Yatekii/project-powerline/doc/fb_fhnwreport/preamble/title.tex

\title{%
    \vspace{60mm}
    \Huge{Fachbericht} \\
    %\huge{(Entwurf)}
    \date{\today}
}
