Yatekii/project-powerline/doc/fb_fhnwreport/sections/firmware.tex

An  dieser  Stelle wird  genauer  erl\"autert,  welche \"Uberlegungen  in  die
Firmware  unseres  Systems  geflossen  sind. Weil  Sensor  und  Master-Ger\"at
jeweils  eine   eigene  Firmware   ben\"otigen,  ist  auch   dieser  Abschnitt
entsprechend aufgeteilt.

\anweisung   Diagramme    zur   Erkl\"arung    des   Aufbaus    der   Firmware
verwenden. Trockener    Text    \"uber    Software   ist    nicht    besonders
leserfreundlich.

\anweisung Bei der Verwendung von  Libraries sollen diese kurz beschrieben und
der Grund ihrer Wahl erl\"autert werden.

\anweisung   Unterkapitel  entsprechend   Gliederung  der   Firmware  sinnvoll
erg\"anzen.

% ---------------------------------------------------------------------------- %
\subsection{Sensorplatine}
\label{subsec:fw:sensorplatine}
% ---------------------------------------------------------------------------- %

Sinnvolle Beschreibung der Firmware des Sensors.

% ---------------------------------------------------------------------------- %
\subsection{Master-Ger\"at}
\label{subsec:fw:mastergerat}
% ---------------------------------------------------------------------------- %

Unterbau, GSM-Modul, Benutzeroberfl\"ache. Wichtigster Punkt: Datenauswertung.

% ---------------------------------------------------------------------------- %
\subsection{Kommunikation/Protokoll}
\label{subsec:fw:sensorplatine}
% ---------------------------------------------------------------------------- %

Wie im Abschnitt  zur Hardware wird in einem  separaten Abschnitt beschrieben,
welche \"Uberlegungen in die Entwicklung  des Protokolls eingeflossen sind und
wie das Ergebnis aussieht.
