Yatekii/project-powerline/doc/fb_fhnwreport/titlepage/titlepage.tex

\begin{titlepage}

    \maketitle

    %\vspace{60mm}
    \vspace{50mm}

    %\hspace{-20mm}
    \begin{tabular}{r|l}

        \textsc{\textbf{Studiengang}}
        & EIT\\
        [4mm]

        \textsc{\textbf{Modul}}
        & Projekt 4 \\
        [4mm]

        \textsc{\textbf{Team}}
        & 3 \\
        [4mm]

        \textsc{\textbf{Autoren}}
        & Marcel Heymann, Noah H\"usser, Raphael Frey, Dominik Keller,  \\
        & Marco Koch, Reto Nussbaumer, Francesco Rovelli                \\
        [4mm]

        \textsc{\textbf{Version}}
        & 0.1 \\
    \end{tabular}
    %\end{center}

\end{titlepage}
