Yatekii/project-powerline/admin/ph_org/sections/projektbudget.tex

% comment

% TODO: Materialkosten

Die  Personalkosten  basieren  auf  einem  Stundenansatz  von  148  CHF  f\"ur
den  Projektleiter und  74 CHF  f\"ur regul\"are  Projektmitarbeiter. Gem\"ass
ECTS-Credits stehen  nominal 1260 Stunden  zur Verf\"ugung ($7  Personen \cdot
30  Stunden/Credit \cdot  6 Credits$). Abbildung  \ref{fig:persCost} ist  eine
graphische Darstellung der Projektkosten, Tabelle \ref{tab:persCost} enth\"alt
die entsprechende Auflistung.

\begin{figure}[h!]
    \centering
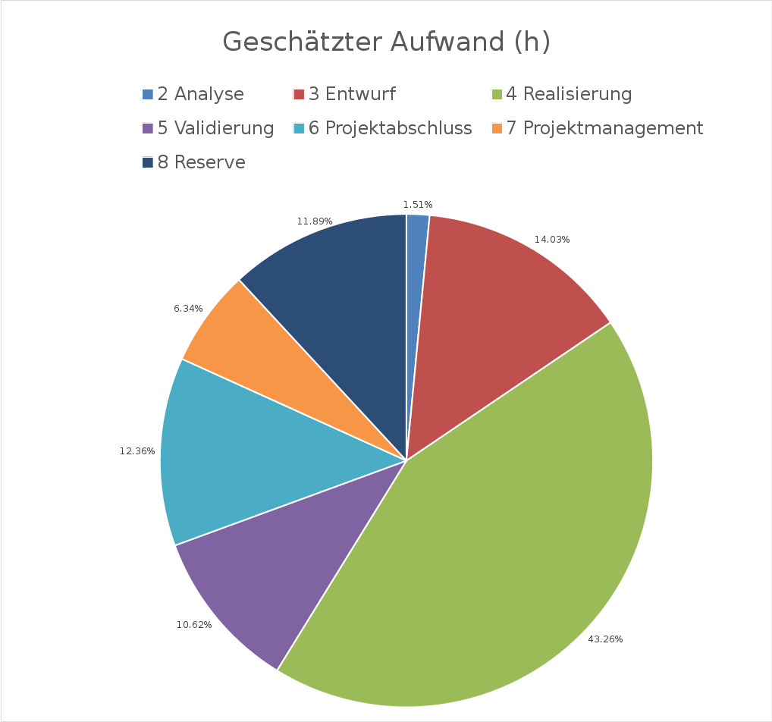
[picture p3: admin/ph_org/images/budget.png]
    
    \caption{Personalkosten}
    \label{fig:persCost}
\end{figure}

\begin{center}
    \captionof{table}{Personalkosten}
    \label{tab:persCost}
    \begin{tabular}{lp{20mm}p{20mm}p{20mm}p{20mm}}
        \toprule
                           & \multicolumn{4}{c}{gesch\"atzter Aufwand} \\
        \midrule
        Projektphase       & Anteil an Gesamtstunden (\%) & Personen-stunden (h) & Anteil an Gesamtkosten (\%) & Kosten (CHF) \\
        \midrule
        2 Analyse            &                         1.51 &                  19 &                        1.42 &        1406 \\
        3 Entwurf            &                        14.03 &                 177 &                       13.19 &       13098 \\
        4 Realisierung       &                        43.26 &                 546 &                       40.69 &       40404 \\
        5 Validierung        &                        10.62 &                 134 &                        9.99 &        9916 \\
        6 Projektabschluss   &                        12.36 &                 156 &                       11.62 &       11544 \\
        7 Projektmanagement  &                         6.34 &                  80 &                       11.92 &       11840 \\
        8 Reserve            &                        11.89 &                 150 &                       11.18 &       11100 \\
        \midrule
        \textsc{Total}       &                       100.00 &                1262 &                      100.00 &       99308 \\
        \bottomrule
    \end{tabular}
\end{center}
