Yatekii/project-powerline/admin/ph_fachl/sections/projektvereinbarung.tex

%$\square$ Projekt wird genehmigt. \\
%$\square$ Projekt wird nicht genehmigt.\\

\rule{10mm}{0.05em} Projekt wird genehmigt. \hspace{20mm} \rule{10mm}{0.05em} Projekt wird nicht genehmigt.\\

Windisch, \today \\

\begin{tabular}{p{80mm}p{80mm}}
    \parbox[t][][t]{55mm}{
        \textbf{Hans Gysin, Auftraggeber}
        \vspace*{10mm} \\
        \rule{70mm}{0.05em} \\
        Unterschrift
    } \\
    [30mm]

    \parbox[t][][t]{55mm}{
        \textbf{Reto Nussbaumer, TL}
        \vspace*{10mm} \\
        \rule{70mm}{0.05em} \\
        Unterschrift \\
    }

    &

    \parbox[t][][t]{55mm}{
        \textbf{Marco Koch}
        \vspace*{10mm} \\
        \rule{70mm}{0.05em} \\
        Unterschrift \\
    } \\
    [10mm]

    \parbox[t][][t]{55mm}{
        \textbf{Noah H\"usser}
        \vspace*{10mm} \\
        \rule{70mm}{0.05em} \\
        Unterschrift \\
    }

    &

    \parbox[t][][t]{55mm}{
        \textbf{Dominik Keller}
        \vspace*{10mm} \\
        \rule{70mm}{0.05em} \\
        Unterschrift \\
    } \\
    [10mm]

    \parbox[t][][t]{55mm}{
        \textbf{Francesco Rovelli}
        \vspace*{10mm} \\
        \rule{70mm}{0.05em} \\
        Unterschrift
    }

    &

    \parbox[t][][t]{55mm}{
        \textbf{Marcel Heymann}
        \vspace*{10mm} \\
        \rule{70mm}{0.05em} \\
        Unterschrift
    } \\
    [25mm]

    \parbox[t][][t]{55mm}{
        \textbf{Raphael Frey}
        \vspace*{10mm} \\
        \rule{70mm}{0.05em} \\
        Unterschrift
    }
\end{tabular}
