Yatekii/project-powerline/admin/ph_org/sections/appendix.tex

%\section{Zeitplan, Grossversion}
%\label{appendix:zeitplan}
%
%\clearpage
%\setlength\paperheight{297mm}
%\setlength\paperwidth{420mm}
%\setlength\pdfpageheight{\paperheight}
%\setlength\pdfpagewidth{\paperwidth}
%
%\includepdf[page=1,scale=1]{images/zeitplan.pdf}
%
%\setlength\paperheight{297mm}
%\setlength\paperwidth{210mm}
%\setlength\pdfpageheight{\paperheight}
%\setlength\pdfpagewidth{\paperwidth}

% ---------------------------------------------------------------------------- %
\section{Projektstrukturplan}
\label{app:psp}
% ---------------------------------------------------------------------------- %

\clearpage
\setlength\paperheight{297mm}
\setlength\paperwidth{420mm}
\setlength\pdfpageheight{\paperheight}
\setlength\pdfpagewidth{\paperwidth}

\includepdf[page=1-2,scale=1]{images/psp.pdf}

\setlength\paperheight{297mm}
\setlength\paperwidth{210mm}
\setlength\pdfpageheight{\paperheight}
\setlength\pdfpagewidth{\paperwidth}
