Yatekii/project-powerline/admin/ph_org/sections/kommunikationskonzept.tex

% comment

%\begin{landscape}
%\vspace*{-10mm}
Das     Kommunikationskonzept     unseres     Teams    ist     aus     Tabelle
\ref{tab:kommunikationskonzept} ersichtlich.

\begin{table}[!h]
    \small
    \caption{Kommunikationskonzept}
    \label{tab:kommunikationskonzept}
    \begin{longtable}{
        >{\raggedright}p{31mm}
        >{\raggedright}p{50mm}
        >{\raggedright}p{50mm}
        >{\raggedright}p{30mm}
        >{\raggedright}p{30mm}
        >{\raggedright\arraybackslash}p{30mm}}
    \toprule

      \textsc{Aufgabe}
    & \textsc{Zweck}
    & \textsc{Empf\"anger}
    & \textsc{Mittel}
    & \textsc{H\"aufigkeit}
    & \textsc{Verantwortl.} \\

    \midrule
    \endhead
    \midrule
    \endfoot
    \bottomrule
    \endlastfoot

    %\rowcolor[gray]{0.9}

    Kommunikation Fachdozenten
    & Fragen bei Unklarheiten
    & Fachdozenten
    & E-Mail
    & Bei Bedarf
    & PL Reto Nussbaumer \\
    [2mm]

    \rowcolor{black!10}
    Kommunikation Auftraggeber
    & Fragen bei Unklarheiten, Koordination
    & Auftraggeber
    & E-Mail
    & Bei Bedarf
    & PL Reto Nussbaumer \\
    [2mm]

    Kommunkation innerhalb Gruppe
    & Informationsaustausch, Koordination
    & Projektgruppe
    & WhatsApp, E-Mail, Slack
    & Bei Bedarf
    & Projektmitglieder \\
    [2mm]

    \rowcolor{black!10}
    Sitzungseinladung
    & Information, Koordination
    & Projektgruppe
    & WhatsApp, E-Mail
    & Bei Bedarf
    & PL Reto Nussbaumer \\
    [2mm]

    Sitzungsprotokoll
    & Pendenzen, Entscheide festhalten, orientieren
    & Projektgruppe
    & Dropbox
    & Sonntag nach jeder Sitzung
    & PL Stv. Marco Koch \\
    [2mm]

    \rowcolor{black!10}
    Pflichtenheft
    & Detaillierte Analyse der Anforderungen des Auftraggebers
    & Auftraggeber, M. Meier, P. Schleuniger, P. Buchschacher
    & E-Mail, Dropbox
    & Gem\"ass Drehbuch
    & PL Reto Nussbaumer \\
    [2mm]

    Statusbericht
    & Aktuellen Arbeitsstand festhalten
    & Auftraggeber, Fachdozenten, Projektgruppe
    & E-Mail, Dropbox
    & Gem\"ass Drehbuch
    & PL Reto Nussbaumer \\
    [2mm]

    \rowcolor{black!10}
    Zwischenpr\"asentation
    & Pr\"asentation Zwischenergebnisse
    & Auftraggeber, Fachdozenten, Projektgruppe
    & Pers\"onlich
    & Gem\"ass Drehbuch
    & Projektmitglieder \\
    [2mm]

    Schlusspr\"asentation
    & Pr\"asentation Ergebnisse
    & Auftraggeber, Fachdozenten, alle Projektgruppen
    & Pers\"onlich
    & Gem\"ass Drehbuch
    & Projektmitglieder \\

    \bottomrule
    \end{longtable}
\end{table}

%\end{landscape}
