Yatekii/project-powerline/admin/README.md

Pflichtenhefter, organisatorisch und fachlich
