Yatekii/project-powerline/admin/ph_org/preamble/title.tex

\title{%
    \vspace{60mm}
    \Huge{Pflichtenheft -- Organisatorischer Teil}
    \date{\today}
}
