Yatekii/project-powerline/doc/fb_fhnwreport/sections/fazit.tex

Was  l\"auft? Was  l\"auft  nicht? Weshalb? Weiteres Vorgehen  bei  gen\"ugend
Zeit? Schwierigkeiten w\"ahren des Projekts?
