Yatekii/project-powerline/doc/simulations/jac--m5sf-2/jac--m6sf-3--iv-curve--1.png

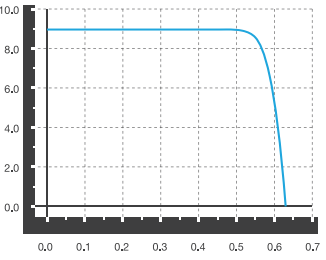
doc/simulations/jac--m5sf-2/jac--m6sf-3--iv-curve--1.png
