Yatekii/project-powerline/doc/fb_memoir/chapters/testphase.tex

% **************************************************************************** %
\chapter{Testphase}
\label{chap:testphase}
% **************************************************************************** %

Im Folgenden  wird dargelegt,  welche Tests  an unserem  System durchgef\"uhrt
worden  sind, weshalb  die  durchgef\"uhrten Tests  relevant  sind und  welche
Ergebnisse erzielt werden konnten.

\anweisung  Welche   Tests  sind   \"uberhaupt  notwendig,  um   die  korrekte
Funktionali\"at der jeweiligen Subsysteme zu verifizieren?

\anweisung Allenfalls mehr Unterkapitel hinzuf\"ugen, falls sinnvoll.

% ---------------------------------------------------------------------------- %
\section{Sensorplatine}
\label{sec:test:sensorplatine}
% ---------------------------------------------------------------------------- %

% ---------------------------------------------------------------------------- %
\section{Master-Ger\"at}
\label{sec:test:master}
% ---------------------------------------------------------------------------- %
