Yatekii/project-powerline/doc/fb_memoir/python/fsk_measurements/1_layer_power_choke_test.csv

Version=2.1.0.14
Date=06.05.2016 11:39:01
Type=foo
Inspector=
Remark=
IMax [A]=9
UMax [V]=50
TMax [µs]=100
P-Factor for L-values=0
P-Factor for LSUdt-values=0
P-Factor for SUdt-values=0
MeasCount=1
LowLimitI=
UppLimitI=
LowLimitSUdt=
UppLimitSUdt=
Serialpoints=
Divisor for L-values=1000000
Divisor for LSUdt-values=1000000
DigitsI_inc=1
DigitsSUdt_inc=0
DigitsI_sec=1
DigitsSUdt_sec=0
Ohmic resistance[Ohm]=0.2022
Serial-No.=
DPG10 L_inc(I)
0.3 | 138.9698
0.4 | 137.8259
0.5 | 137.8778
0.6 | 138.4815
0.7 | 138.1438
0.8 | 137.1349
0.9 | 136.9904
1.0 | 136.3909
1.1 | 135.7359
1.2 | 136.0925
1.3 | 136.9366
1.4 | 135.4261
1.5 | 134.4522
1.6 | 133.1436
1.7 | 132.4993
1.8 | 130.1671
1.9 | 129.5655
2.0 | 127.9529
2.1 | 125.2561
2.2 | 123.0008
2.3 | 120.0295
2.4 | 117.5924
2.5 | 114.2326
2.6 | 110.3993
2.7 | 106.051
2.8 | 101.0052
2.9 | 95.54311
3.0 | 89.97378
3.1 | 84.13519
3.2 | 77.99895
3.3 | 71.31776
3.4 | 64.86943
3.5 | 58.33348
3.6 | 52.51378
3.7 | 47.33991
3.8 | 43.01249
3.9 | 39.39716
4.0 | 36.42801
4.1 | 33.91776
4.2 | 31.78533
4.3 | 29.97807
4.4 | 28.41036
4.5 | 27.05453
4.6 | 25.85638
4.7 | 24.80999
4.8 | 23.84345
4.9 | 22.94344
5.0 | 22.14482
5.1 | 21.4234
5.2 | 20.77436
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
