Yatekii/project-powerline/doc/fb_memoir/python/fsk_measurements/1_layer_power_choke_test_zoom.csv

Version=2.1.0.14
Date=06.05.2016 11:41:37
Type=foo
Inspector=
Remark=
IMax [A]=5
UMax [V]=50
TMax [µs]=100
P-Factor for L-values=0
P-Factor for LSUdt-values=0
P-Factor for SUdt-values=0
MeasCount=1
LowLimitI=
UppLimitI=
LowLimitSUdt=
UppLimitSUdt=
Serialpoints=
Divisor for L-values=1000000
Divisor for LSUdt-values=1000000
DigitsI_inc=2
DigitsSUdt_inc=0
DigitsI_sec=2
DigitsSUdt_sec=0
Ohmic resistance[Ohm]=0.2023
Serial-No.=
DPG10 L_inc(I)
0.25 | 137.102
0.30 | 137.756
0.35 | 137.9878
0.40 | 137.4489
0.45 | 137.9692
0.50 | 138.832
0.55 | 139.6832
0.60 | 139.3316
0.65 | 138.8455
0.70 | 138.461
0.75 | 138.649
0.80 | 138.5057
0.85 | 138.8541
0.90 | 138.689
0.95 | 138.7219
1.00 | 137.8271
1.05 | 137.6815
1.10 | 137.0918
1.15 | 137.2209
1.20 | 136.6025
1.25 | 136.8542
1.30 | 137.0282
1.35 | 136.8775
1.40 | 136.3299
1.45 | 135.4548
1.50 | 135.0466
1.55 | 134.2076
1.60 | 134.497
1.65 | 134.5565
1.70 | 133.0759
1.75 | 131.7955
1.80 | 130.4676
1.85 | 130.4269
1.90 | 129.2524
1.95 | 128.4621
2.00 | 126.8568
2.05 | 125.9252
2.10 | 124.822
2.15 | 123.8328
2.20 | 122.554
2.25 | 120.2069
2.30 | 118.7336
2.35 | 116.7979
2.40 | 115.2494
2.45 | 113.6834
2.50 | 111.9591
2.55 | 110.3461
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
