Yatekii/project-powerline/admin/pma/images/ursache-wirkung.pdf

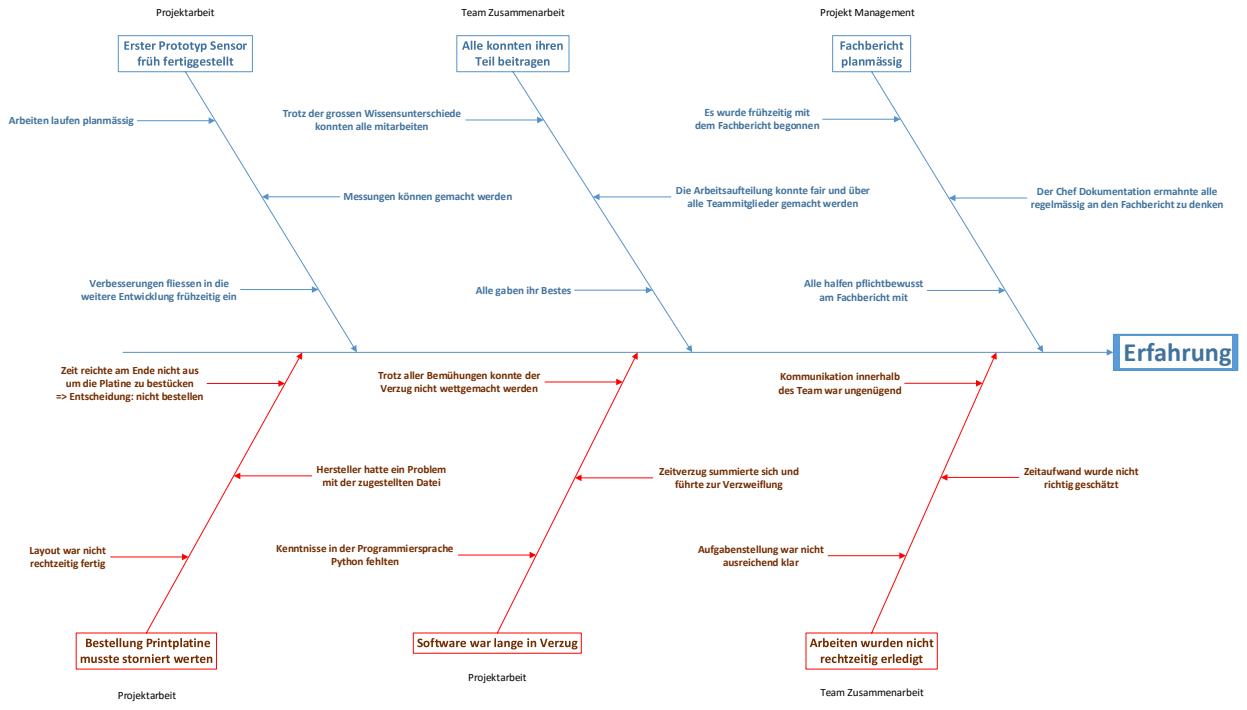
[picture p52: page 1]
Erfahrung; Python fehlten; Projektarbeit; Team Zusammenarbeit; Projekt Management

Trotz der grossen Wissensunterschiede
konnten alle mitarbeiten

Es wurde frühzeitig mit
dem Fachbericht begonnen

Arbeiten laufen planmässig

Die Arbeitsaufteilung konnte fair und über
alle Teammitglieder gemacht werden

Der Chef Dokumentation ermahnte alle
regelmässig an den Fachbericht zu denken

Messungen können gemacht werden

Verbesserungen fliessen in die
weitere Entwicklung frühzeitig ein

Alle gaben ihr Bestes

Alle halfen pflichtbewusst
am Fachbericht mit

Zeit reichte am Ende nicht aus
um die Platine zu bestücken
=> Entscheidung: nicht bestellen

Trotz aller Bemühungen konnte der
Verzug nicht wettgemacht werden

Kommunikation innerhalb
des Team war ungenügend

Hersteller hatte ein Problem
mit der zugestellten Datei

Zeitverzug summierte sich und
führte zur Verzweiflung

Zeitaufwand wurde nicht
richtig geschätzt

Layout war nicht
rechtzeitig fertig

Kenntnisse in der Programmiersprache

Aufgabenstellung war nicht
ausreichend klar
