Yatekii/project-powerline/doc/simulations/jac--m5sf-2/JAC M6SF-3 (Cypress2).pdf

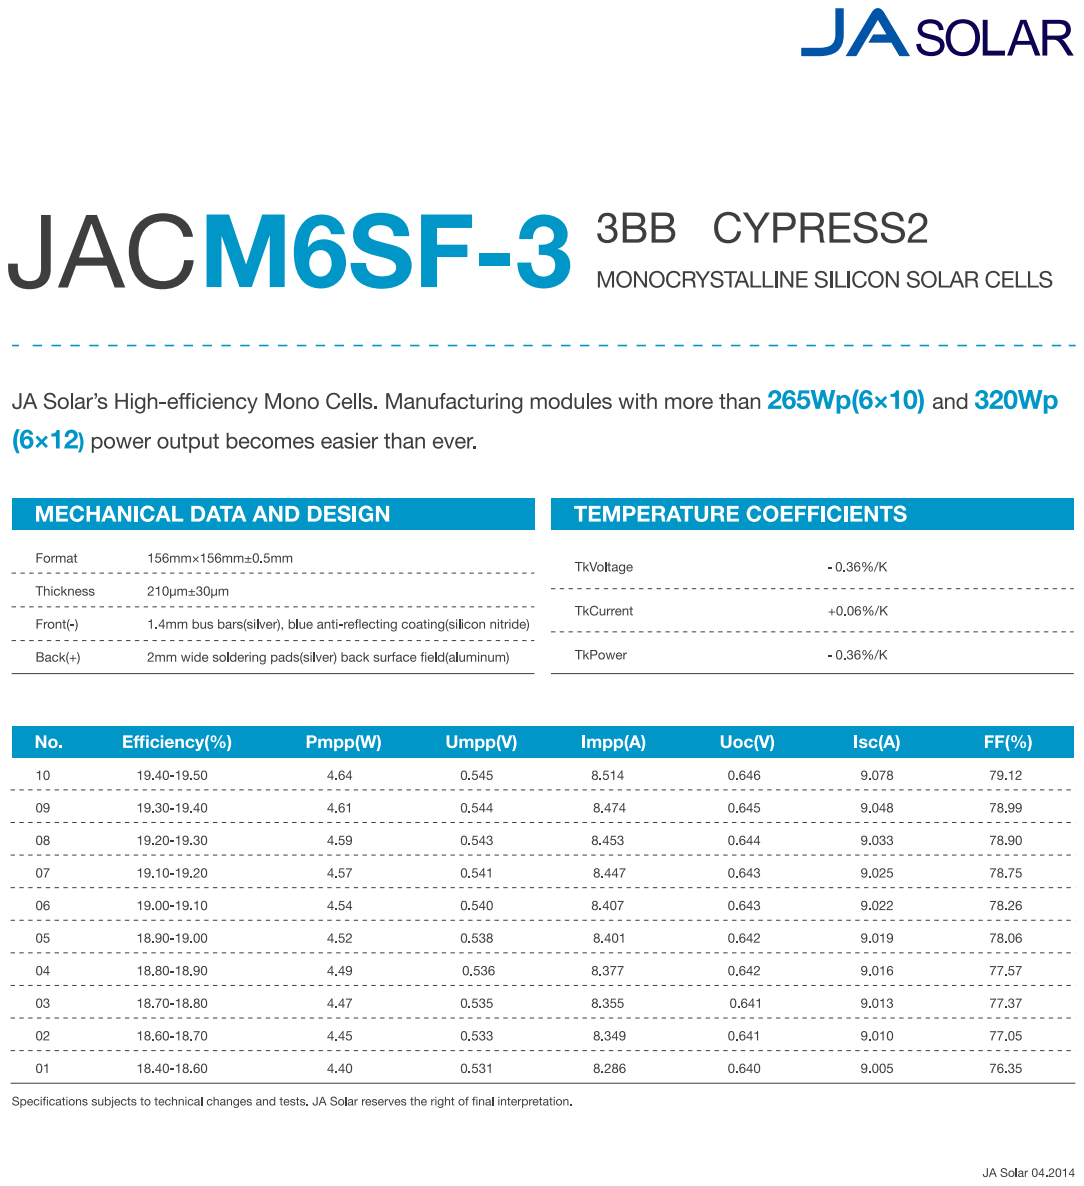
[picture p53: page 1]

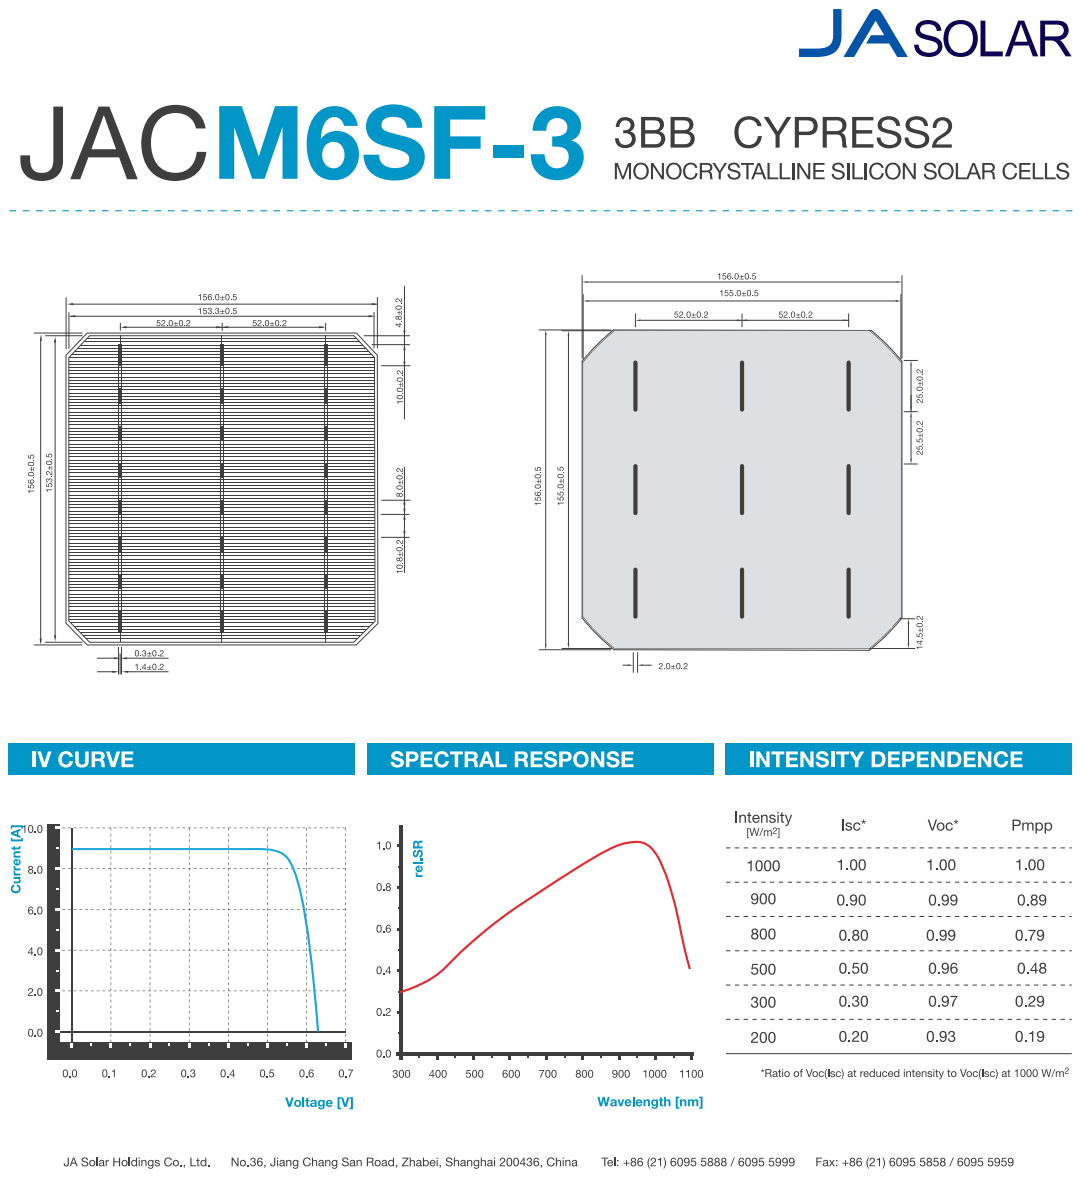
[picture p54: page 2]
