Yatekii/project-powerline/admin/ph_org/images/organigramm.pdf

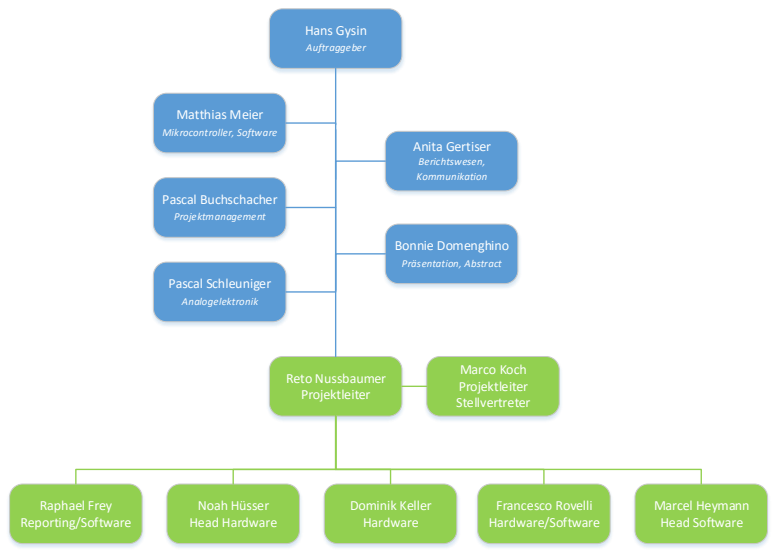
[picture p55: page 1]
Hans Gysin; Auftraggeber; Matthias Meier; Mikrocontroller, Software; Pascal Schleuniger; Analogelektronik; Pascal Buchschacher; Projektmanagement; Bonnie Domenghino; Präsentation, Abstract; Reto Nussbaumer Projektleiter; Marco Koch Projektleiter Stellvertreter; Francesco Rovelli Hardware/Software; Noah Hüsser Head Hardware; Marcel Heymann Head Software; Dominik Keller Hardware; Raphael Frey Reporting/Software; Anita Gertiser; Berichtswesen, Kommunikation
