Yatekii/project-powerline/doc/fb_memoir/images/ltspice/jac/capacitive-eps-converted-to.pdf

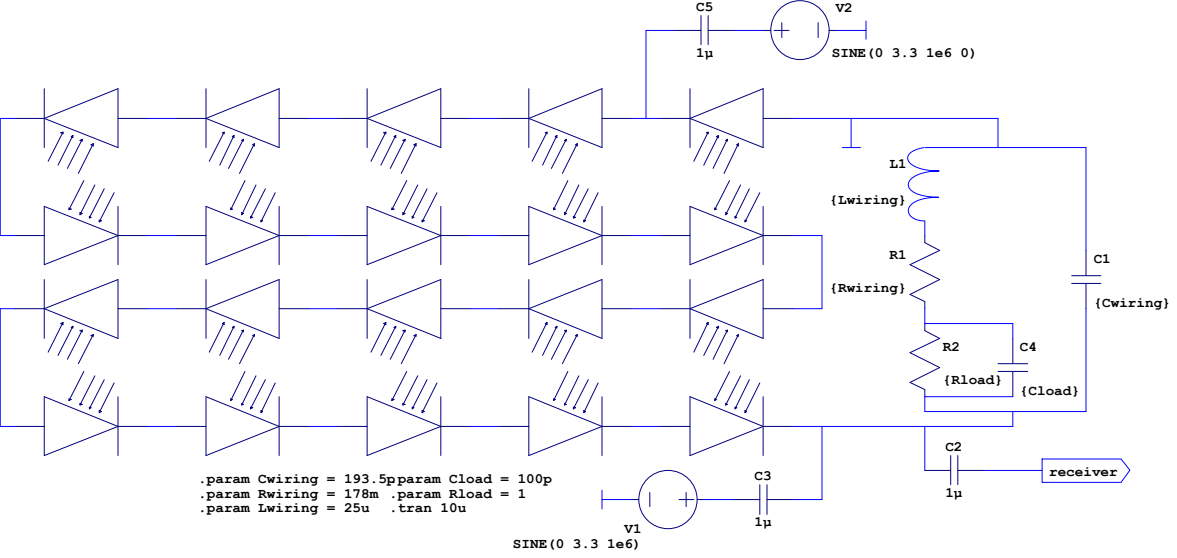
[picture p56: page 1]

.param Cwiring = 193.5p.param Cload = 100p
.param Rwiring = 178m
.param Lwiring = 25u
