Yatekii/project-powerline/hardware/supervisor/sim/Draft1.asc

C1: cap; 1µ
D1: diode; 1N914
D2: diode; 1N914
R1: res; 1
R2: res; 1000
V1: voltage; PULSE(960 900 0 10e-10 10e-10 10u 20u)
V2: voltage; 10
Named nets: 0, OUT
.tran 10m
