Yatekii/project-powerline/hardware/supervisor/sim/RX.asc

C1: cap; 100n
L1: ind; 22m
M1: nmos; BSS123
M2: pmos; BSS84
R1: res; 4k
R2: res; 1k
R3: res; 10k
R4: res; 100
R5: res; 1.5k
R6: res; 1k
R7: res; 1k
V1: voltage; PULSE(192 180 0 10e-10 10e-10 1us 2us)
V2: voltage; 3.3
Named nets: 0, IN, OUT, DIVIDER, BIASED, INVERTED
.tran 0 10ms 0 uic
