Yatekii/project-powerline/hardware/sensor/sim/sensor.asc

C2: cap; 0.8µ
C3: cap; 0.8µ
C6: cap; 0.8µ
C8: cap; 0.8µ
D1: diode; 1N914
D2: diode; 1N914
D3: diode; 1N914
D4: diode; 1N914
I1: current; 10
I3: current; 10
L1: ind; 10m
L2: ind; 10m
L4: ind; 10m
L5: ind; 10m
RL1: res; 12
RL: res; 12
V1: voltage; SINE(0 3 10k)
V2: voltage; SINE(0 1.533 10k)
Named nets: 0
.tran 100ms
