Yatekii/project-powerline/doc/simulations/jac--m5sf-2/block/test.asc

R1: res; 1
X1: jacModule; Ifail=2
Named nets: 0
.tran 1m
