Yatekii/project-powerline/doc/simulations/jac--m5sf-2/jac--m5sf-2.asc

C1: cap; {Cp}
D1: diode; diffusion
D2: diode; recombination
I1: current; {Iph}
R1: res; {Rsh}
R2: res; {Rs}
R3: res; {Rload}
Named nets: IN, OUT, 0
.model diffusion D IS=7.9406e-11 N=1
.model recombination D IS=5.0762e-6 N=2
.param Rs = 0.00171
.param Rsh = 59.23
.param Cp = 6.94u
.param Iph = 5.889
.dc dec param Rload 1e-20 1k 50 param Iph 0.05889 5.889 1.25
