Yatekii/project-powerline/doc/CD/ltspice/short/string.asc

C1: cap; 193.5p
C2: cap; {Cload}
C3: cap; 100µ
D1: zener; diodePro4
D2: zener; diodePro4
L1: ind; 25µ
M1: nmos; mos1
R1: res; 178m
R2: res; {Rload}
R3: res; 10k
R4: res; 10k
R5: res; 10k
R6: res; 1e6
V1: voltage; PULSE(0 3.3 0 0 0 {Ton} {Tperiod})
V2: voltage; 3.3
X1: jacModule
X2: jacModule
X3: jacModule
X4: jacModule
X5: jacModule
X6: jacModule
X7: jacModule
X8: jacModule
X9: jacModule
X10: jacModule
X11: jacModule
X12: jacModule
X13: jacModule
X14: jacModule
X15: jacModule
X16: jacModule
X17: jacModule
X18: jacModule
X19: jacModule
X20: jacModule
Named nets: SIGNAL, 0, RECEIVER, 3.3V
.tran 1m
.param Rload = 1000
.param Cload = 10n
.model mos1 VDMOS(Ron=20m)
.model mos1 VDMOS(Rg=3 Vto=1.7 Rd=8m Rs=6m Rb=10m Kp=70 Cgdmax=2.5n Cgdmin=.4n Cgs=2n Cjo=1n Is=80p Vds=100 Ron=20m Qg=40n)
.model diodebp D
.step dec param Cload = 1u 100u 1 dec param Rload 10 100k 1
.step dec param Rload 10 10k 1
.step dec param Cload = 1n 100u 1
.param Ton = 0.5 * Tperiod
.param Tperiod = 1e-4
.step dec param Tperiod = 1e-2 1e-5 1
.model diodePro4 D(Is=.88f Rs=.25 Cjo=175p M=.55 bv=2.7 Vj=.75 Isr=1.86n Nr=2 Ibv=20.254m Ibvl=1.96m Nbvl=15 Tbv1=-21.3u Vpk=60 type=Zener)
