Yatekii/project-powerline/doc/CD/ltspice/jac/string.asc

R1: res; {Rload}
X1: jacModule; Ifail = {Ifailure1}
X2: jacModule; Ifail = {Ifailure2}
X3: jacModule
X4: jacModule
X5: jacModule
X6: jacModule
X7: jacModule
X8: jacModule
X9: jacModule
X10: jacModule
X11: jacModule
X12: jacModule
X13: jacModule
X14: jacModule
X15: jacModule
X16: jacModule
X17: jacModule
X18: jacModule
X19: jacModule
X20: jacModule
Named nets: IN, OUT, 0
.dc dec param Rload 1e-10 1k 10 param Ifailure1 1 5.889 2 param Ifailure2 1 5.889 2
.dc dec param Rload 1e-20 100k 50 param Ifailure1 0.05889 5.889 1.25 param Ifailure2 2.94 5.889 1.47
.param Ifailure2 = 5.889
