Yatekii/project-powerline/doc/CD/ltspice/jac/stringNoD.asc

R1: res; {Rload}
X1: jacModuleNoD; Ifail = {Ifailure}
X6: jacModuleNoD
X7: jacModuleNoD
X8: jacModuleNoD
X10: jacModuleNoD
X11: jacModuleNoD
X12: jacModuleNoD
X13: jacModuleNoD
X14: jacModuleNoD
X15: jacModuleNoD
X16: jacModuleNoD
X17: jacModuleNoD
X18: jacModuleNoD
X19: jacModuleNoD
X20: jacModuleNoD
X21: jacModuleNoD
X22: jacModuleNoD
X23: jacModuleNoD
X24: jacModuleNoD
X25: jacModuleNoD
Named nets: IN, OUT, 0
.dc dec param Rload 1e-20 100k 50 param Ifailure 0.05889 5.889 1.25
.dc dec param Rload 1e-10 1k 20 param Ifailure 0.5 5.889 2
