Yatekii/project-powerline/doc/CD/ltspice/capacitive/capacitive.asc

C1: cap; {Cwiring}
C2: cap; 1µ
C3: cap; 1µ
C4: cap; {Cload}
C5: cap; 1µ
L1: ind; {Lwiring}
R1: res; {Rwiring}
R2: res; {Rload}
V1: voltage; SINE(0 3.3 1e6)
V2: voltage; SINE(0 3.3 1e6 0)
X1: jacModule
X2: jacModule
X3: jacModule
X4: jacModule
X5: jacModule
X6: jacModule
X7: jacModule
X8: jacModule
X9: jacModule
X10: jacModule
X11: jacModule
X12: jacModule
X13: jacModule
X14: jacModule
X15: jacModule
X16: jacModule
X17: jacModule
X18: jacModule
X19: jacModule
X20: jacModule
Named nets: receiver, 0
.tran 10u
.param Rload = 10
.param Cload = 10u
.param Cwiring = 193.5p
.param Rwiring = 178m
.param Lwiring = 25u
.step dec param Rload 1 1k 1 dec param Cload 1n 100u 1
