Yatekii/project-powerline/doc/CD/ltspice/inductive/singleModule.asc

L1: ind2; 500n
L2: ind2; 500n
L3: ind2; 200µ
L4: ind2; 200µ
R1: res; {Rload}
R2: res; 1e6
R3: res; 1p
V1: voltage; SINE(0 3.3 1e6)
X1: jacModule
Named nets: 0, RECEIVER
.tran 10u
K1 L1 L4 0.95
K2 L2 L3 0.95
.param Rload = 10
