Yatekii/project-powerline/doc/CD/ltspice/inductive/string.asc

C1: cap; {Cwiring}
C4: cap; {Cload}
L1: ind; {Lwiring}
L2: ind2; 500n
L3: ind2; 500n
L4: ind2; 200µ
L5: ind2; 200µ
L6: ind2; 500n
L7: ind2; 200µ
R1: res; {Rwiring}
R2: res; {Rload}
R3: res; 1p
R4: res; 1k
V1: voltage; SINE(0 3.3 1e6)
V2: voltage; SINE(0 3.3 {Freq})
X1: jacModule
X2: jacModule
X3: jacModule
X4: jacModule
X5: jacModule
X6: jacModule
X7: jacModule
X8: jacModule
X9: jacModule
X10: jacModule
X11: jacModule
X12: jacModule
X13: jacModule
X14: jacModule
X15: jacModule
X16: jacModule
X17: jacModule
X18: jacModule
X19: jacModule
X20: jacModule
Named nets: receiver, 0
.tran 200u
.param Rload = 50
.param Cload = 100u
.param Cwiring = 193.5p
.param Rwiring = 178m
.param Lwiring = 25u
K1 L2 L4 0.95
K2 L3 L5 0.95
K3 L6 L7 0.95
.step dec param Rload 1 1k 1
.step dec param Cload 1n 100u 1 dec param Rload 1 50 1
.param Freq = 243902
.step dec param Freq 1e4 1e7 1
.param Tperiod = 4.1e-6
.param Ton = 0.5*Tperiod
