Yatekii/project-powerline/doc/CD/ltspice/short/receiver.asc

C1: cap; 100µ
C2: cap; 100µ
D1: zener; diodePro4
D2: zener; diodePro4
L1: ind; 100µ
R1: res; 10k
R2: res; 10k
R3: res; 10k
R4: res; 1e6
R5: res; 1k
V1: voltage; PULSE(0 -45 1 0 0 0.5e-4 1e-4)
V2: voltage; 900
V3: voltage; 3.3
Named nets: 0, RECEIVER, 3.3V
.tran 0 10 0 1m
.model diodePro4 D(bv=2.7 Is=.88f Rs=.25 Cjo=175p M=.55 Vj=.75 Isr=1.86n Nr=2 Ibv=20.254m Ibvl=1.96m Nbvl=15 Tbv1=-21.3u Vpk=60 type=Zener)
