Yatekii/project-powerline/doc/CD/ltspice/short/single.asc

M1: nmos; mos1
R1: res; {Rload}
V1: voltage; PULSE(0 3.3 0 0 0 0.5e-4 1e-4)
X1: jacModule
Named nets: MEASURE, 0
.tran 0 61u 59u
.model mos1 VDMOS(Kp = 60 Ron=20m)
.model diodebp D
.param Rload = 100
.tran 1m
