Yatekii/project-powerline/doc/simulations/jac--m5sf-2/block/shortcircuit-cells.asc

C1: cap; {Cp}
C2: cap; {Cp}
C3: cap; {Cp}
C4: cap; {Cp}
C5: cap; {Cp}
C6: cap; {Cp}
C7: cap; {Cp}
C8: cap; {Cp}
C9: cap; {Cp}
C10: cap; {Cp}
C11: cap; {Cp}
C12: cap; {Cp}
C13: cap; {Cp}
C14: cap; {Cp}
C15: cap; {Cp}
C16: cap; {Cp}
C17: cap; {Cp}
C18: cap; {Cp}
C19: cap; {Cp}
C20: cap; {Cp}
C21: cap; {Cp}
C22: cap; {Cp}
C23: cap; {Cp}
C24: cap; {Cp}
C25: cap; {Cp}
C26: cap; {Cp}
C27: cap; {Cp}
C28: cap; {Cp}
C29: cap; {Cp}
C30: cap; {Cp}
C31: cap; {Cp}
C32: cap; {Cp}
C33: cap; {Cp}
C34: cap; {Cp}
C35: cap; {Cp}
C36: cap; {Cp}
C37: cap; {Cp}
C38: cap; {Cp}
C39: cap; {Cp}
C40: cap; {Cp}
C41: cap; {Cp}
C42: cap; {Cp}
C43: cap; {Cp}
C44: cap; {Cp}
C45: cap; {Cp}
C46: cap; {Cp}
C47: cap; {Cp}
C48: cap; {Cp}
C49: cap; {Cp}
C50: cap; {Cp}
C51: cap; {Cp}
C52: cap; {Cp}
C53: cap; {Cp}
C54: cap; {Cp}
C55: cap; {Cp}
C56: cap; {Cp}
C57: cap; {Cp}
C58: cap; {Cp}
C59: cap; {Cp}
C60: cap; {Cp}
C61: cap; {Cp}
C62: cap; {Cp}
C63: cap; {Cp}
C64: cap; {Cp}
C65: cap; {Cp}
C66: cap; {Cp}
C67: cap; {Cp}
C68: cap; {Cp}
C69: cap; {Cp}
C70: cap; {Cp}
C71: cap; {Cp}
C72: cap; {Cp}
C73: cap; {Cp}
C74: cap; {Cp}
C75: cap; {Cp}
C76: cap; {Cp}
C77: cap; {Cp}
C78: cap; {Cp}
C79: cap; {Cp}
C80: cap; {Cp}
C81: cap; {Cp}
C82: cap; {Cp}
C83: cap; {Cp}
C84: cap; {Cp}
C85: cap; {Cp}
C86: cap; {Cp}
C87: cap; {Cp}
C88: cap; {Cp}
C89: cap; {Cp}
C90: cap; {Cp}
C91: cap; {Cp}
C92: cap; {Cp}
C93: cap; {Cp}
C94: cap; {Cp}
C95: cap; {Cp}
C96: cap; {Cp}
C97: cap; {Cp}
C98: cap; {Cp}
C99: cap; {Cp}
C100: cap; {Cp}
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
.model diffusion D IS=7.9406e-11 N=1
.model recombination D IS=5.0762e-6 N=2
.param Rs = 0.00171
.param Rsh = 59.23
.param Cp = 3.125u
.param Iph = 5.889
.param Ifail = 5.889
.model diodebp D
.param LConductor = 8.74u
.param RConductor = 44.21m
.model mos1 VDMOS(Ron=20m)
.tran 1m
