Yatekii/project-powerline/doc/simulations/jac--m5sf-2/block/inductive-verySimple.asc

L1: ind2; 144n
L2: ind2; 130µ
L3: ind2; 144n
L4: ind2; 130µ
R1: res; 1p
R2: res; 1k
R3: res; 1p
V1: voltage; SINE(0 3.3 1e6)
Named nets: 0, RECEIVER
K1 L1 L2 0.8
K2 L3 L4 0.8
.tran 10u
