Yatekii/project-powerline/doc/CD/ltspice/generic/cell-9A.asc

C1: cap; {Cp}
D1: diode; diffusion
D2: diode; recombination
I1: current; {Iph}
R1: res; {Rsh}
R2: res; {Rs}
Named nets: IN, OUT
.model diffusion D IS=7.9406e-11 N=1
.model recombination D IS=5.0762e-6 N=2
.param Rs = 0.00171
.param Rsh = 20
.param Cp = 6.94u
.param Iph = 9
.dc dec param Rload 1e-20 1k 50
