Yatekii/project-powerline/hardware/sensor/sensor.kicad_pcb

## KiCad design hardware/sensor/sensor.kicad_pcb (2016-06-16)

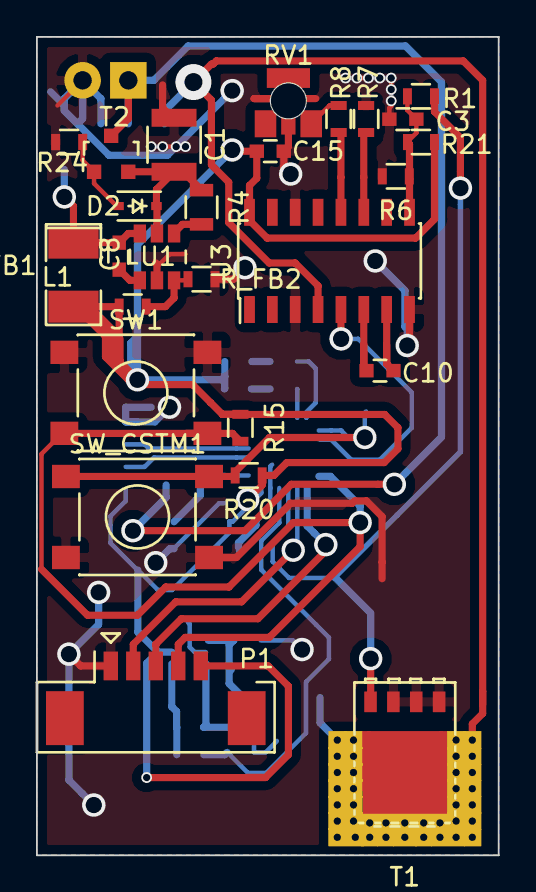
[picture p57: board sensor.kicad_pcb from above]

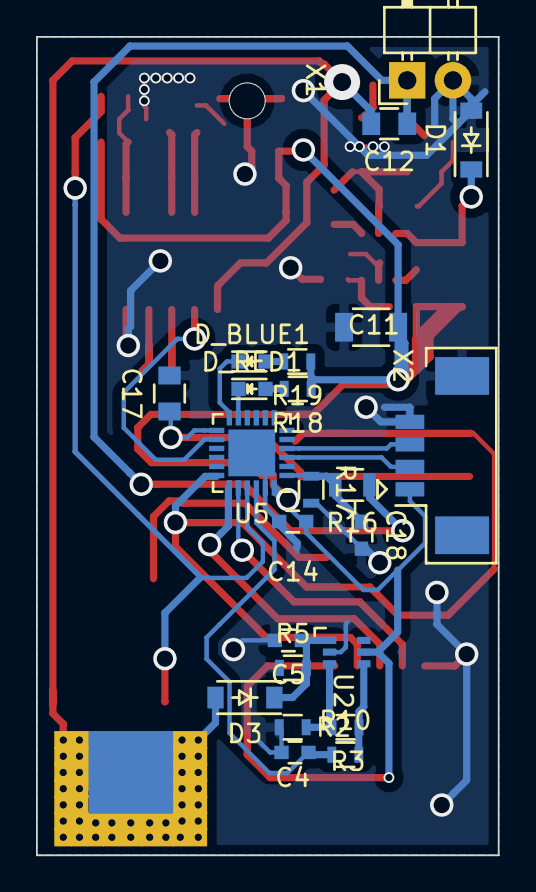
[picture p58: board sensor.kicad_pcb from below]

Board: 2 copper layers, 25.7 x 45.5 mm, 49 parts (23 on the bottom side), 33 nets.

Parts:
C1: 2.2uF; C_1210
C3, C4, C10, C18: C_Small; C_0603
C5: 0.1u; C_0603
C8: 100nF; C_0603
C11: 10uF; C_1206
C12: C_Small; C_0805
C14, C15: 100n; C_0603
C17: 1u; C_0805
D1, D3: D_Schottky_Small; SOD-123
D2: ZENER; SOD-323
D_BLUE1: BLUE; LED_0603
D_RED1: RED; LED_0603
L1: 22uH; SMD-1210_Pol
P1: CONN_01X05; Molex_PicoBlade_53261-0571
R1, R15, R20: 10k; R_0603
R2, R3, R21, R24: 100k; R_0603
R4: 1M8; R_0805
R5, R7, R8, R10: R_Small; R_0603
R6: x; R_0603
R16: 600k; R_0805
R17: 33k; R_0603
R18, R19: 100; R_0603
RV1: POT; EVM-1USX30B14_poti
R_FB1: 33k; R_0603
R_FB2: 10k; R_0603
SW1: Reset; SW_SPST_PTS645
SW_CSTM1: Cstm; SW_SPST_PTS645
T1: BUK9Y22; SOT-669_LFPAK_ThermalVias-1
T2: DMP10H4D2s; SOT-23
U1: LMR16006; TSOT-6-MK06A
U2: OPA376AIDCK; SC-70-6
U3: CD74HC4046; SOIC-16_3.9x9.9mm_Pitch1.27mm
U5: Atmel_SAM_D09; QFN-24-1EP_4x4mm_Pitch0.5mm
X1: 60V; Pin_Header_Angled_1x02
X2: UART; Molex_PicoBlade_53261-0471

Connections:
+3V3: C11.1, C14.1, C15.1, L1.2, P1.5, R15.1, R18.1, R19.1, R20.1, R21.1, R_FB1.1, U2.5, U3.16, U5.24, X2.1
/BLUE_ON: D_BLUE1.1, U5.12
/INH-Tx: U3.5, U5.14
/RED_ON: D_RED1.1, U5.11
/RX1_out: C4.1, R10.1, U5.22
/SHD: R4.2, U1.4
/SW_CSTM: C17.1, R20.2, SW_CSTM1.1, U5.13
/TX1_in: R1.2, T1.4, U5.21
/adc_0: C18.1, R16.2, R17.1, U5.1
/coupling: C12.2, D3.2, T1.5, U3.4
GND: C1.2, C3.2, C4.2, C5.2, C11.2, C14.2, C15.2, C17.2, C18.2, D1.2, P1.1, R2.2, R5.1, R6.2, R7.2, R17.2, R24.2, RV1.2, R_FB2.2, SW1.1, SW_CSTM1.2, T1.1, T1.2, T1.3, U1.2, U2.2, U3.3, U3.8, U3.14, U5.23, U5.25, X1.2, X2.4
unnamed: C1.1, D2.1, R4.1, T2.2, U1.5
unnamed: C3.1, R1.1, R6.1, R21.2, U3.9
unnamed: C5.1, D3.1, R5.2, U2.1
unnamed: C8.1, U1.1
unnamed: C8.2, D1.1, L1.1, U1.6
unnamed: C10.1, U3.6
unnamed: C10.2, U3.7
unnamed: D2.2, R24.1, T2.1
unnamed: D_BLUE1.2, R19.2
unnamed: D_RED1.2, R18.2
unnamed: P1.2, U5.20
unnamed: P1.3, U5.19
unnamed: P1.4, R15.2, SW1.2, U5.18
unnamed: R2.1, R3.2, U2.3
unnamed: R7.1, U3.11
unnamed: R8.1, U3.12
unnamed: R8.2, RV1.3
unnamed: R3.1, R10.2, U2.4
unnamed: R_FB1.2, R_FB2.1, U1.3
unnamed: U5.3, X2.2
unnamed: U5.4, X2.3
VCC: C12.1, R16.1, T2.3, X1.1
