Yatekii/project-powerline/hardware/supervisor/supervisor.kicad_pcb

## KiCad design hardware/supervisor/supervisor.kicad_pcb (2016-06-16)

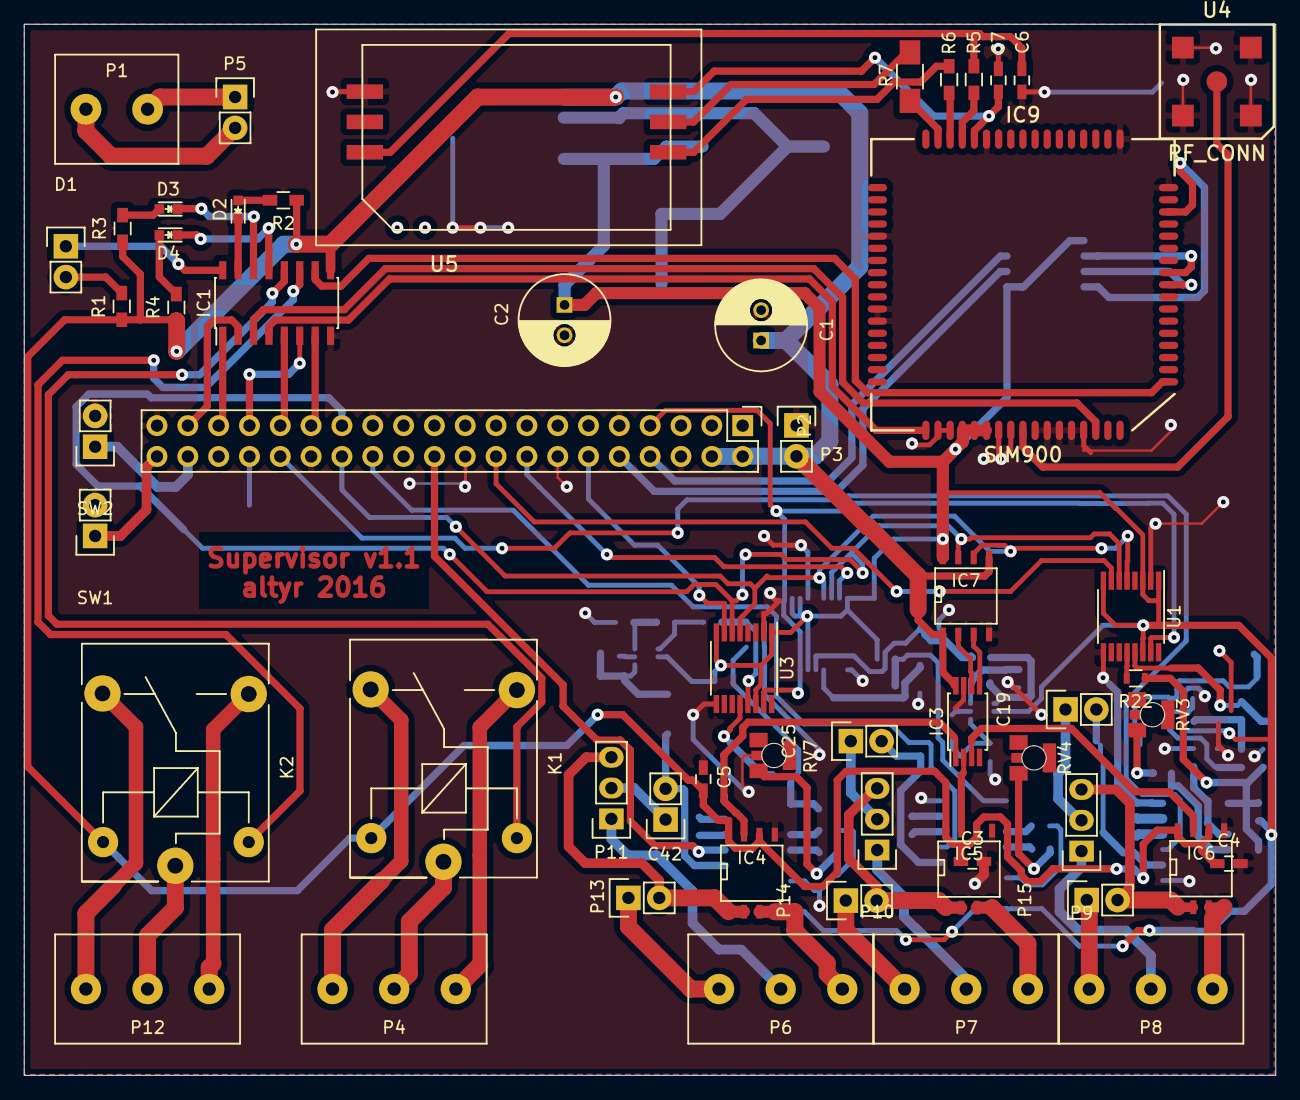
[picture p59: board supervisor.kicad_pcb from above]

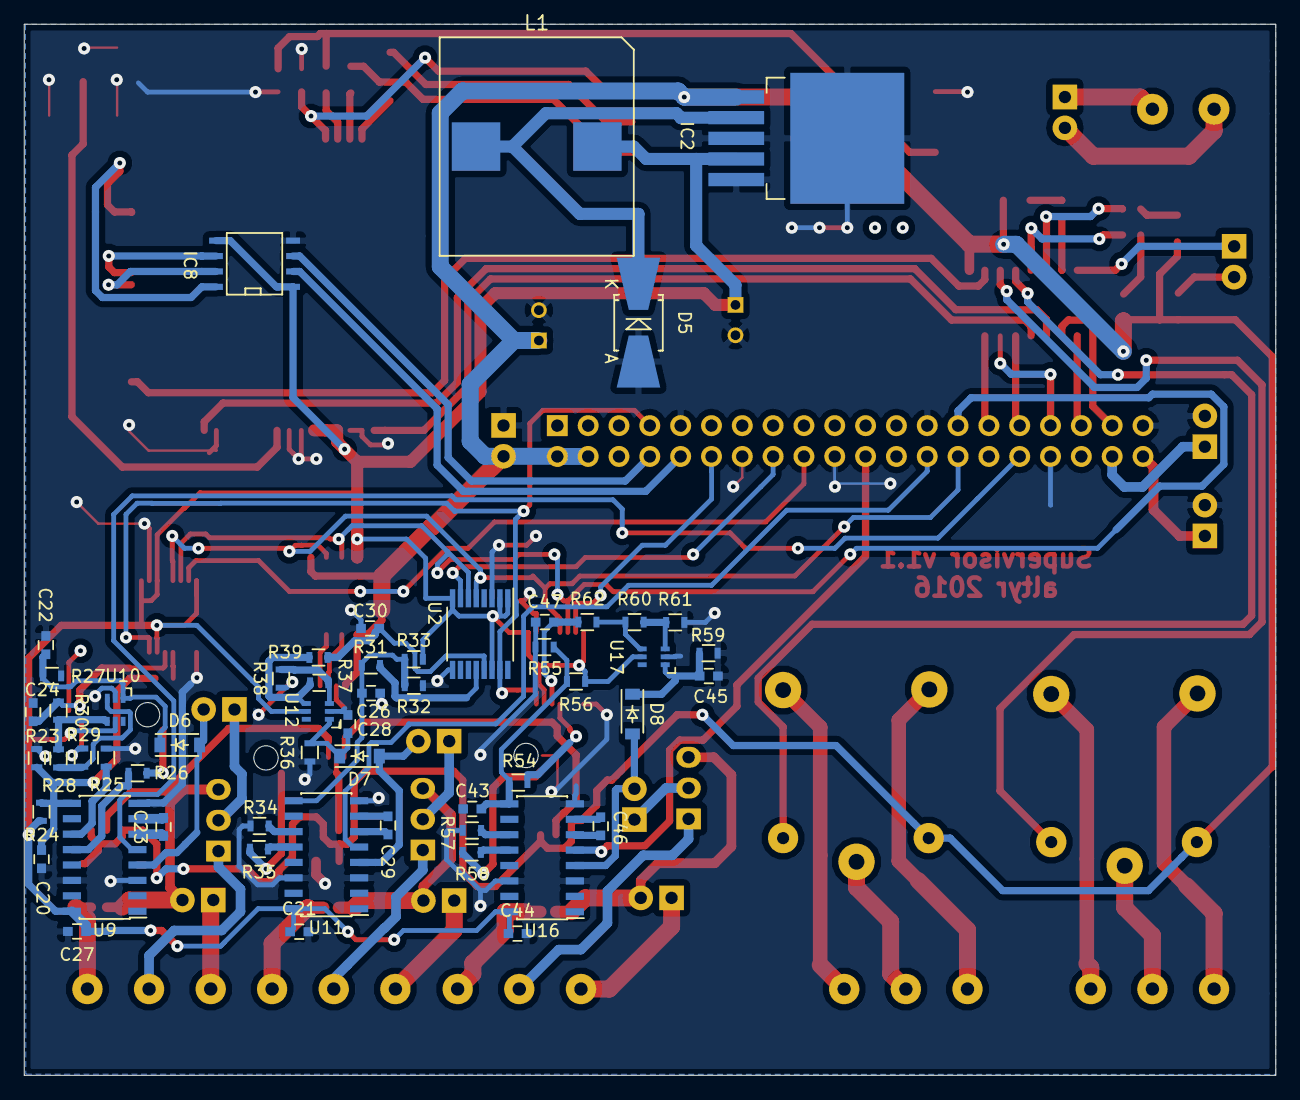
[picture p60: board supervisor.kicad_pcb from below]

Board: 2 copper layers, 103.1 x 86.6 mm, 110 parts (55 on the bottom side), 110 nets.

Parts:
C1, C2: CP_Small; C_Radial_D7.5_L11.2_P2.5
C3, C4, C5: 0.1 uF; C_0603_HandSoldering
C6: 22pF; C_0603_HandSoldering
C7: 100nF; C_0603_HandSoldering
C19, C25, C42: C_Small; Pin_Header_Straight_1x02
C20, C23, C24, C26, C29, C30, C43, C46, C47: C_Small; C_0603
C21, C27, C44: 100n; C_0603
C22, C28, C45: 0.1u; C_0603
D1: Led_Small; Pin_Header_Straight_1x02
D2, D3, D4: Led_Small; LED_0603
D5: ZENERsmall; SMB-SMC_Universal_Handsoldering
D6, D7, D8: D_Schottky_Small; SOD-123
IC1: ULN2003A; SOIC-16_3.9x9.9mm_Pitch1.27mm
IC2: LM2596-3.3; TO-263-5Lead
IC3: MAX11612; TSSOP-8_4.4x3mm_Pitch0.65mm
IC4, IC5, IC6: ACS723LLCTR-10AU-T; SOIC-8-N
IC7, IC8: NLSX4373; SOIC-8-N
IC9: SIM900; QFP 68
K1, K2: RELAY_SERIE_36
L1: INDUCTOR_Small; HC9-large
P1: 230V_IN; CONNECTOR-input
P2: RASPI-CONNECT; Pin_Header_Straight_2x20
P3: POWER; Pin_Header_Straight_1x02
P4, P6, P7, P8, P12: CONN_01X03; CONNECTOR-relay
P5, P13, P14, P15: 230V_OUT; Pin_Header_Straight_1x02
P9, P10, P11: CONN_01X03; Pin_Header_Straight_1x03
R1, R2, R3, R4: R_Small; R_0603_HandSoldering
R5, R6: 22; R_0603_HandSoldering
R7: 22; R_1206_HandSoldering
R22, R31, R54: 10k; R_0603
R23, R32, R55: x; R_0603
R24, R28, R29, R33, R37, R38, R56, R60, R61: 100k; R_0603
R25, R26, R27, R30, R34, R35, R36, R39, R57, R58, R59, R62: R_Small; R_0603
RV3, RV4, RV7: POT; EVM-1USX30B14_poti
SW1, SW2: SW_PUSH; Pin_Header_Straight_1x02
U1, U2, U3: SC16IS740IPW; TSSOP-16_4.4x5mm_Pitch0.65mm
U4: RF_CONN; SMA_SMD
U5: SIM_HOLDER
U9, U11, U16: CD74HC4046; SOIC-16_3.9x9.9mm_Pitch1.27mm
U10, U12, U17: OPA376AIDCK; SC-70-6

Connections:
+3V3: C2.1, C21.1, C27.1, C44.1, IC2.4, IC7.8, IC8.1, IC8.5, IC9.55, IC9.56, IC9.57, L1.2, R24.1, R33.1, R56.1, U1.1, U1.3, U1.8, U1.14, U2.1, U2.2, U2.8, U2.14, U3.1, U3.8, U3.14, U9.16, U10.5, U11.16, U12.5, U16.16, U17.5
+5V: C1.1, C3.1, C4.1, C5.1, IC1.9, IC2.1, IC3.8, IC4.6, IC4.8, IC5.6, IC5.8, IC6.6, IC6.8, IC7.1, IC7.5, K1.A1, K2.A1, P2.2, P2.4, P3.2, R1.1, R2.1, R3.1, R4.1
/FSK Module 1/coupling1: C19.2, D6.2, U9.4
/FSK Module 1/incoming1: C24.1, R30.1, U1.13
/FSK Module 1/outgoing1: R22.2, U1.12
/FSK Module 2/coupling2: C25.2, D7.2, U11.4
/FSK Module 2/incoming2: C30.1, R39.1, U2.13
/FSK Module 2/outgoing2: R31.2, U2.12
/FSK Module 3/coupling3: C42.2, D8.2, U16.4
/FSK Module 3/incoming3: C47.1, R62.1, U3.13
/FSK Module 3/outgoing3: R54.2, U3.12
BT0: P2.40, SW1.1
BT1: P2.38, SW2.1
ENSK0: P2.22, U16.5
ENSK1: P2.26, U11.5
ENSK2: P2.32, U9.5
GND: C1.2, C2.2, C3.2, C4.2, C5.2, C6.2, C7.2, C20.2, C21.2, C22.2, C24.2, C26.2, C27.2, C28.2, C30.2, C43.2, C44.2, C45.2, C47.2, D5.2, IC1.8, IC2.3, IC2.5, IC3.7, IC4.5, IC5.5, IC6.5, IC7.4, IC8.4, IC9.17, IC9.18, IC9.29, IC9.39, IC9.45, IC9.46, IC9.53, IC9.54, IC9.58, IC9.59, IC9.61, IC9.62, IC9.63, IC9.64, IC9.65, P2.6, P2.9, P2.14, P2.20, P2.25, P2.30, P2.34, P2.39, P3.1, R23.2, R25.2, R27.1, R29.2, R32.2, R34.2, R36.1, R38.2, R55.2, R57.2, R59.1, R61.2, RV3.2, RV4.2, RV7.2, SW1.2, SW2.2, U1.2, U1.9, U2.3, U2.9, U3.2, U3.3, U3.9, U4.2, U5.C5, U9.3, U9.8, U9.14, U10.2, U11.3, U11.8, U11.14, U12.2, U16.3, U16.8, U16.14, U17.2
GSM_LED0: IC1.3, IC9.66
GSM_LED1: IC1.4, IC9.52
GSM_PKEY: IC1.10, IC9.1
GSM_PWR: IC1.7, P2.29
IRQ0: P2.12, U3.7
IRQ1: P2.16, U2.7
IRQ2: P2.18, U1.7
LED0: IC1.1, P2.35
LED1: IC1.2, P2.37
MUCLK: P2.7, U1.15, U2.15, U3.15
unnamed: C6.1, R5.1, U5.C7
unnamed: C7.1, IC9.30, U5.C1
unnamed: C19.1, P9.2
unnamed: C20.1, R22.1, R23.1, R24.2, U9.9
unnamed: C22.1, D6.1, R27.2, U10.1
unnamed: C23.1, U9.6
unnamed: C23.2, U9.7
unnamed: C25.1, P10.2
unnamed: C26.1, R31.1, R32.1, R33.2, U11.9
unnamed: C28.1, D7.1, R36.2, U12.1
unnamed: C29.1, U11.6
unnamed: C29.2, U11.7
unnamed: C42.1, P11.2
unnamed: C43.1, R54.1, R55.1, R56.2, U16.9
unnamed: C45.1, D8.1, R59.2, U17.1
unnamed: C46.1, U16.6
unnamed: C46.2, U16.7
unnamed: D1.1, IC1.16
unnamed: D1.2, R1.2
unnamed: D2.1, IC1.15
unnamed: D2.2, R2.2
unnamed: D3.1, IC1.14
unnamed: D3.2, R3.2
unnamed: D4.1, IC1.13
unnamed: D4.2, R4.2
unnamed: D5.1, IC2.2, L1.1
unnamed: IC1.11, K2.A2
unnamed: IC1.12, K1.A2
unnamed: IC3.5, IC7.3
unnamed: IC3.6, IC7.2
unnamed: IC8.6, IC9.10
unnamed: IC8.7, IC9.9
unnamed: IC8.8, IC9.15
unnamed: IC9.31, R5.2
unnamed: IC9.32, R6.1
unnamed: IC9.33, R7.2
unnamed: IC9.60, U4.1
unnamed: K1.11, P4.2
unnamed: K1.12, P4.3
unnamed: K1.14, P4.1
unnamed: K2.11, P12.2
unnamed: K2.12, P12.3
unnamed: K2.14, P12.1
unnamed: P1.1, P5.2
unnamed: P1.2, P5.1
unnamed: P6.3, P13.1
unnamed: P7.3, P14.1
unnamed: P8.3, P15.1
unnamed: R6.2, U5.C3
unnamed: R7.1, U5.C2
unnamed: R25.1, U9.11
unnamed: R26.1, U9.12
unnamed: R26.2, RV3.3
unnamed: R28.1, R30.2, U10.4
unnamed: R28.2, R29.1, U10.3
unnamed: R34.1, U11.11
unnamed: R35.1, U11.12
unnamed: R35.2, RV4.3
unnamed: R37.1, R39.2, U12.4
unnamed: R37.2, R38.1, U12.3
unnamed: R57.1, U16.11
unnamed: R58.1, U16.12
unnamed: R58.2, RV7.3
unnamed: R60.1, R62.2, U17.4
unnamed: R60.2, R61.1, U17.3
PGND0: P6.2, P11.1
PGND1: P7.2, P10.1
PGND2: P8.2, P9.1
RLY0: IC1.5, P2.31
RLY1: IC1.6, P2.33
RXD: IC8.2, P2.10
SCL: IC7.6, P2.28, U1.5, U2.5, U3.5
SDA: IC7.7, P2.27, U1.6, U2.6, U3.6
TXD: IC8.3, P2.8
isense0: IC3.1, IC4.7
isense1: IC3.2, IC5.7
isense2: IC3.3, IC6.7
string_in0: IC4.1, IC4.2, P11.3, P13.2
string_in1: IC5.1, IC5.2, P10.3, P14.2
string_in2: IC6.1, IC6.2, P9.3, P15.2
string_out0: IC4.3, IC4.4, P6.1
string_out1: IC5.3, IC5.4, P7.1
string_out2: IC6.3, IC6.4, P8.1
