Yatekii/project-powerline/software/sensor/P0werline/atmel_start_pins.h

/*
 * Code generated from Atmel Start.
 *
 * This file will be overwritten when reconfiguring your Atmel Start project.
 * Please copy examples or other code you want to keep to a separate file
 * to avoid losing it when reconfiguring.
 */
#ifndef ATMEL_START_PINS_H_INCLUDED
#define ATMEL_START_PINS_H_INCLUDED

#include <hal_gpio.h>

#define PA02  GPIO(GPIO_PORTA, 2)
#define PA04  GPIO(GPIO_PORTA, 4)
#define PA05  GPIO(GPIO_PORTA, 5)
#define LED_RED  GPIO(GPIO_PORTA, 14)
#define LED_GREEN  GPIO(GPIO_PORTA, 15)

#endif // ATMEL_START_PINS_H_INCLUDED
