Yatekii/project-powerline/software/sensor/P0werline/include/samd09c13a.h

/**
 * \file
 *
 * \brief Header file for SAMD09C13A
 *
 * Copyright (c) 2015 Atmel Corporation. All rights reserved.
 *
 * \asf_license_start
 *
 * \page License
 *
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
 * 3. The name of Atmel may not be used to endorse or promote products derived
 *    from this software without specific prior written permission.
 *
 * 4. This software may only be redistributed and used in connection with an
 *    Atmel microcontroller product.
 *
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
 * \asf_license_stop
 *
 */

#ifndef _SAMD09C13A_
#define _SAMD09C13A_

/**
 * \ingroup SAMD09_definitions
 * \addtogroup SAMD09C13A_definitions SAMD09C13A definitions
 * This file defines all structures and symbols for SAMD09C13A:
 *   - registers and bitfields
 *   - peripheral base address
 *   - peripheral ID
 *   - PIO definitions
*/
/*@{*/

#ifdef __cplusplus
 extern "C" {
#endif

#if !(defined(__ASSEMBLY__) || defined(__IAR_SYSTEMS_ASM__))
#include <stdint.h>
#ifndef __cplusplus
typedef volatile const uint32_t RoReg;   /**< Read only 32-bit register (volatile const unsigned int) */
typedef volatile const uint16_t RoReg16; /**< Read only 16-bit register (volatile const unsigned int) */
typedef volatile const uint8_t  RoReg8;  /**< Read only  8-bit register (volatile const unsigned int) */
#else
typedef volatile       uint32_t RoReg;   /**< Read only 32-bit register (volatile const unsigned int) */
typedef volatile       uint16_t RoReg16; /**< Read only 16-bit register (volatile const unsigned int) */
typedef volatile       uint8_t  RoReg8;  /**< Read only  8-bit register (volatile const unsigned int) */
#endif
typedef volatile       uint32_t WoReg;   /**< Write only 32-bit register (volatile unsigned int) */
typedef volatile       uint16_t WoReg16; /**< Write only 16-bit register (volatile unsigned int) */
typedef volatile       uint32_t WoReg8;  /**< Write only  8-bit register (volatile unsigned int) */
typedef volatile       uint32_t RwReg;   /**< Read-Write 32-bit register (volatile unsigned int) */
typedef volatile       uint16_t RwReg16; /**< Read-Write 16-bit register (volatile unsigned int) */
typedef volatile       uint8_t  RwReg8;  /**< Read-Write  8-bit register (volatile unsigned int) */
#define CAST(type, value) ((type *)(value))
#define REG_ACCESS(type, address) (*(type*)(address)) /**< C code: Register value */
#else
#define CAST(type, value) (value)
#define REG_ACCESS(type, address) (address) /**< Assembly code: Register address */
#endif

/* ************************************************************************** */
/**  CMSIS DEFINITIONS FOR SAMD09C13A */
/* ************************************************************************** */
/** \defgroup SAMD09C13A_cmsis CMSIS Definitions */
/*@{*/

/** Interrupt Number Definition */
typedef enum IRQn
{
  /******  Cortex-M0+ Processor Exceptions Numbers ******************************/
  NonMaskableInt_IRQn      = -14,/**<  2 Non Maskable Interrupt                 */
  HardFault_IRQn           = -13,/**<  3 Cortex-M0+ Hard Fault Interrupt        */
  SVCall_IRQn              = -5, /**< 11 Cortex-M0+ SV Call Interrupt           */
  PendSV_IRQn              = -2, /**< 14 Cortex-M0+ Pend SV Interrupt           */
  SysTick_IRQn             = -1, /**< 15 Cortex-M0+ System Tick Interrupt       */
  /******  SAMD09C13A-specific Interrupt Numbers ***********************/
  PM_IRQn                  =  0, /**<  0 SAMD09C13A Power Manager (PM) */
  SYSCTRL_IRQn             =  1, /**<  1 SAMD09C13A System Control (SYSCTRL) */
  WDT_IRQn                 =  2, /**<  2 SAMD09C13A Watchdog Timer (WDT) */
  RTC_IRQn                 =  3, /**<  3 SAMD09C13A Real-Time Counter (RTC) */
  EIC_IRQn                 =  4, /**<  4 SAMD09C13A External Interrupt Controller (EIC) */
  NVMCTRL_IRQn             =  5, /**<  5 SAMD09C13A Non-Volatile Memory Controller (NVMCTRL) */
  DMAC_IRQn                =  6, /**<  6 SAMD09C13A Direct Memory Access Controller (DMAC) */
  EVSYS_IRQn               =  8, /**<  8 SAMD09C13A Event System Interface (EVSYS) */
  SERCOM0_IRQn             =  9, /**<  9 SAMD09C13A Serial Communication Interface 0 (SERCOM0) */
  SERCOM1_IRQn             = 10, /**< 10 SAMD09C13A Serial Communication Interface 1 (SERCOM1) */
  TC1_IRQn                 = 13, /**< 13 SAMD09C13A Basic Timer Counter 1 (TC1) */
  TC2_IRQn                 = 14, /**< 14 SAMD09C13A Basic Timer Counter 2 (TC2) */
  ADC_IRQn                 = 15, /**< 15 SAMD09C13A Analog Digital Converter (ADC) */
  PTC_IRQn                 = 18, /**< 18 SAMD09C13A Peripheral Touch Controller (PTC) */

  PERIPH_COUNT_IRQn        = 19  /**< Number of peripheral IDs */
} IRQn_Type;

typedef struct _DeviceVectors
{
  /* Stack pointer */
  void* pvStack;

  /* Cortex-M handlers */
  void* pfnReset_Handler;
  void* pfnNMI_Handler;
  void* pfnHardFault_Handler;
  void* pfnReservedM12;
  void* pfnReservedM11;
  void* pfnReservedM10;
  void* pfnReservedM9;
  void* pfnReservedM8;
  void* pfnReservedM7;
  void* pfnReservedM6;
  void* pfnSVC_Handler;
  void* pfnReservedM4;
  void* pfnReservedM3;
  void* pfnPendSV_Handler;
  void* pfnSysTick_Handler;

  /* Peripheral handlers */
  void* pfnPM_Handler;                    /*  0 Power Manager */
  void* pfnSYSCTRL_Handler;               /*  1 System Control */
  void* pfnWDT_Handler;                   /*  2 Watchdog Timer */
  void* pfnRTC_Handler;                   /*  3 Real-Time Counter */
  void* pfnEIC_Handler;                   /*  4 External Interrupt Controller */
  void* pfnNVMCTRL_Handler;               /*  5 Non-Volatile Memory Controller */
  void* pfnDMAC_Handler;                  /*  6 Direct Memory Access Controller */
  void* pfnReserved7;
  void* pfnEVSYS_Handler;                 /*  8 Event System Interface */
  void* pfnSERCOM0_Handler;               /*  9 Serial Communication Interface 0 */
  void* pfnSERCOM1_Handler;               /* 10 Serial Communication Interface 1 */
  void* pfnReserved11;
  void* pfnReserved12;
  void* pfnTC1_Handler;                   /* 13 Basic Timer Counter 1 */
  void* pfnTC2_Handler;                   /* 14 Basic Timer Counter 2 */
  void* pfnADC_Handler;                   /* 15 Analog Digital Converter */
  void* pfnReserved16;
  void* pfnReserved17;
  void* pfnPTC_Handler;                   /* 18 Peripheral Touch Controller */
} DeviceVectors;

/* Cortex-M0+ processor handlers */
void Reset_Handler               ( void );
void NMI_Handler                 ( void );
void HardFault_Handler           ( void );
void SVC_Handler                 ( void );
void PendSV_Handler              ( void );
void SysTick_Handler             ( void );

/* Peripherals handlers */
void PM_Handler                  ( void );
void SYSCTRL_Handler             ( void );
void WDT_Handler                 ( void );
void RTC_Handler                 ( void );
void EIC_Handler                 ( void );
void NVMCTRL_Handler             ( void );
void DMAC_Handler                ( void );
void EVSYS_Handler               ( void );
void SERCOM0_Handler             ( void );
void SERCOM1_Handler             ( void );
void TC1_Handler                 ( void );
void TC2_Handler                 ( void );
void ADC_Handler                 ( void );
void PTC_Handler                 ( void );

/*
 * \brief Configuration of the Cortex-M0+ Processor and Core Peripherals
 */

#define LITTLE_ENDIAN          1        
#define __CM0PLUS_REV          1         /*!< Core revision r0p1 */
#define __MPU_PRESENT          0         /*!< MPU present or not */
#define __NVIC_PRIO_BITS       2         /*!< Number of bits used for Priority Levels */
#define __VTOR_PRESENT         1         /*!< VTOR present or not */
#define __Vendor_SysTickConfig 0         /*!< Set to 1 if different SysTick Config is used */

/**
 * \brief CMSIS includes
 */

#include <core_cm0plus.h>
#if !defined DONT_USE_CMSIS_INIT
#include "system_samd09.h"
#endif /* DONT_USE_CMSIS_INIT */

/*@}*/

/* ************************************************************************** */
/**  SOFTWARE PERIPHERAL API DEFINITION FOR SAMD09C13A */
/* ************************************************************************** */
/** \defgroup SAMD09C13A_api Peripheral Software API */
/*@{*/

#include "component/adc.h"
#include "component/dmac.h"
#include "component/dsu.h"
#include "component/eic.h"
#include "component/evsys.h"
#include "component/gclk.h"
#include "component/hmatrixb.h"
#include "component/mtb.h"
#include "component/nvmctrl.h"
#include "component/pac.h"
#include "component/pm.h"
#include "component/port.h"
#include "component/rtc.h"
#include "component/sercom.h"
#include "component/sysctrl.h"
#include "component/tc.h"
#include "component/wdt.h"
/*@}*/

/* ************************************************************************** */
/**  REGISTERS ACCESS DEFINITIONS FOR SAMD09C13A */
/* ************************************************************************** */
/** \defgroup SAMD09C13A_reg Registers Access Definitions */
/*@{*/

#include "instance/adc.h"
#include "instance/dmac.h"
#include "instance/dsu.h"
#include "instance/eic.h"
#include "instance/evsys.h"
#include "instance/gclk.h"
#include "instance/sbmatrix.h"
#include "instance/mtb.h"
#include "instance/nvmctrl.h"
#include "instance/pac0.h"
#include "instance/pac1.h"
#include "instance/pac2.h"
#include "instance/pm.h"
#include "instance/port.h"
#include "instance/rtc.h"
#include "instance/sercom0.h"
#include "instance/sercom1.h"
#include "instance/sysctrl.h"
#include "instance/tc1.h"
#include "instance/tc2.h"
#include "instance/wdt.h"
/*@}*/

/* ************************************************************************** */
/**  PERIPHERAL ID DEFINITIONS FOR SAMD09C13A */
/* ************************************************************************** */
/** \defgroup SAMD09C13A_id Peripheral Ids Definitions */
/*@{*/

// Peripheral instances on HPB0 bridge
#define ID_PAC0           0 /**< \brief Peripheral Access Controller 0 (PAC0) */
#define ID_PM             1 /**< \brief Power Manager (PM) */
#define ID_SYSCTRL        2 /**< \brief System Control (SYSCTRL) */
#define ID_GCLK           3 /**< \brief Generic Clock Generator (GCLK) */
#define ID_WDT            4 /**< \brief Watchdog Timer (WDT) */
#define ID_RTC            5 /**< \brief Real-Time Counter (RTC) */
#define ID_EIC            6 /**< \brief External Interrupt Controller (EIC) */

// Peripheral instances on HPB1 bridge
#define ID_PAC1          32 /**< \brief Peripheral Access Controller 1 (PAC1) */
#define ID_DSU           33 /**< \brief Device Service Unit (DSU) */
#define ID_NVMCTRL       34 /**< \brief Non-Volatile Memory Controller (NVMCTRL) */
#define ID_PORT          35 /**< \brief Port Module (PORT) */
#define ID_DMAC          36 /**< \brief Direct Memory Access Controller (DMAC) */
#define ID_MTB           38 /**< \brief Cortex-M0+ Micro-Trace Buffer (MTB) */
#define ID_SBMATRIX      39 /**< \brief HSB Matrix (SBMATRIX) */

// Peripheral instances on HPB2 bridge
#define ID_PAC2          64 /**< \brief Peripheral Access Controller 2 (PAC2) */
#define ID_EVSYS         65 /**< \brief Event System Interface (EVSYS) */
#define ID_SERCOM0       66 /**< \brief Serial Communication Interface 0 (SERCOM0) */
#define ID_SERCOM1       67 /**< \brief Serial Communication Interface 1 (SERCOM1) */
#define ID_TC1           70 /**< \brief Basic Timer Counter 1 (TC1) */
#define ID_TC2           71 /**< \brief Basic Timer Counter 2 (TC2) */
#define ID_ADC           72 /**< \brief Analog Digital Converter (ADC) */
#define ID_PTC           75 /**< \brief Peripheral Touch Controller (PTC) */

#define ID_PERIPH_COUNT  76 /**< \brief Max number of peripheral IDs */
/*@}*/

/* ************************************************************************** */
/**  BASE ADDRESS DEFINITIONS FOR SAMD09C13A */
/* ************************************************************************** */
/** \defgroup SAMD09C13A_base Peripheral Base Address Definitions */
/*@{*/

#if defined(__ASSEMBLY__) || defined(__IAR_SYSTEMS_ASM__)
#define ADC                           (0x42002000UL) /**< \brief (ADC) APB Base Address */
#define DMAC                          (0x41004800UL) /**< \brief (DMAC) APB Base Address */
#define DSU                           (0x41002000UL) /**< \brief (DSU) APB Base Address */
#define EIC                           (0x40001800UL) /**< \brief (EIC) APB Base Address */
#define EVSYS                         (0x42000400UL) /**< \brief (EVSYS) APB Base Address */
#define GCLK                          (0x40000C00UL) /**< \brief (GCLK) APB Base Address */
#define SBMATRIX                      (0x41007000UL) /**< \brief (SBMATRIX) APB Base Address */
#define MTB                           (0x41006000UL) /**< \brief (MTB) APB Base Address */
#define NVMCTRL                       (0x41004000UL) /**< \brief (NVMCTRL) APB Base Address */
#define NVMCTRL_CAL                   (0x00800000UL) /**< \brief (NVMCTRL) CAL Base Address */
#define NVMCTRL_LOCKBIT               (0x00802000UL) /**< \brief (NVMCTRL) LOCKBIT Base Address */
#define NVMCTRL_OTP1                  (0x00806000UL) /**< \brief (NVMCTRL) OTP1 Base Address */
#define NVMCTRL_OTP2                  (0x00806008UL) /**< \brief (NVMCTRL) OTP2 Base Address */
#define NVMCTRL_OTP4                  (0x00806020UL) /**< \brief (NVMCTRL) OTP4 Base Address */
#define NVMCTRL_TEMP_LOG              (0x00806030UL) /**< \brief (NVMCTRL) TEMP_LOG Base Address */
#define NVMCTRL_USER                  (0x00804000UL) /**< \brief (NVMCTRL) USER Base Address */
#define PAC0                          (0x40000000UL) /**< \brief (PAC0) APB Base Address */
#define PAC1                          (0x41000000UL) /**< \brief (PAC1) APB Base Address */
#define PAC2                          (0x42000000UL) /**< \brief (PAC2) APB Base Address */
#define PM                            (0x40000400UL) /**< \brief (PM) APB Base Address */
#define PORT                          (0x41004400UL) /**< \brief (PORT) APB Base Address */
#define PORT_IOBUS                    (0x60000000UL) /**< \brief (PORT) IOBUS Base Address */
#define RTC                           (0x40001400UL) /**< \brief (RTC) APB Base Address */
#define SERCOM0                       (0x42000800UL) /**< \brief (SERCOM0) APB Base Address */
#define SERCOM1                       (0x42000C00UL) /**< \brief (SERCOM1) APB Base Address */
#define SYSCTRL                       (0x40000800UL) /**< \brief (SYSCTRL) APB Base Address */
#define TC1                           (0x42001800UL) /**< \brief (TC1) APB Base Address */
#define TC2                           (0x42001C00UL) /**< \brief (TC2) APB Base Address */
#define WDT                           (0x40001000UL) /**< \brief (WDT) APB Base Address */
#else
#define ADC               ((Adc      *)0x42002000UL) /**< \brief (ADC) APB Base Address */
#define ADC_INST_NUM      1                          /**< \brief (ADC) Number of instances */
#define ADC_INSTS         { ADC }                    /**< \brief (ADC) Instances List */

#define DMAC              ((Dmac     *)0x41004800UL) /**< \brief (DMAC) APB Base Address */
#define DMAC_INST_NUM     1                          /**< \brief (DMAC) Number of instances */
#define DMAC_INSTS        { DMAC }                   /**< \brief (DMAC) Instances List */

#define DSU               ((Dsu      *)0x41002000UL) /**< \brief (DSU) APB Base Address */
#define DSU_INST_NUM      1                          /**< \brief (DSU) Number of instances */
#define DSU_INSTS         { DSU }                    /**< \brief (DSU) Instances List */

#define EIC               ((Eic      *)0x40001800UL) /**< \brief (EIC) APB Base Address */
#define EIC_INST_NUM      1                          /**< \brief (EIC) Number of instances */
#define EIC_INSTS         { EIC }                    /**< \brief (EIC) Instances List */

#define EVSYS             ((Evsys    *)0x42000400UL) /**< \brief (EVSYS) APB Base Address */
#define EVSYS_INST_NUM    1                          /**< \brief (EVSYS) Number of instances */
#define EVSYS_INSTS       { EVSYS }                  /**< \brief (EVSYS) Instances List */

#define GCLK              ((Gclk     *)0x40000C00UL) /**< \brief (GCLK) APB Base Address */
#define GCLK_INST_NUM     1                          /**< \brief (GCLK) Number of instances */
#define GCLK_INSTS        { GCLK }                   /**< \brief (GCLK) Instances List */

#define SBMATRIX          ((Hmatrixb *)0x41007000UL) /**< \brief (SBMATRIX) APB Base Address */
#define HMATRIXB_INST_NUM 1                          /**< \brief (HMATRIXB) Number of instances */
#define HMATRIXB_INSTS    { SBMATRIX }               /**< \brief (HMATRIXB) Instances List */

#define MTB               ((Mtb      *)0x41006000UL) /**< \brief (MTB) APB Base Address */
#define MTB_INST_NUM      1                          /**< \brief (MTB) Number of instances */
#define MTB_INSTS         { MTB }                    /**< \brief (MTB) Instances List */

#define NVMCTRL           ((Nvmctrl  *)0x41004000UL) /**< \brief (NVMCTRL) APB Base Address */
#define NVMCTRL_CAL                   (0x00800000UL) /**< \brief (NVMCTRL) CAL Base Address */
#define NVMCTRL_LOCKBIT               (0x00802000UL) /**< \brief (NVMCTRL) LOCKBIT Base Address */
#define NVMCTRL_OTP1                  (0x00806000UL) /**< \brief (NVMCTRL) OTP1 Base Address */
#define NVMCTRL_OTP2                  (0x00806008UL) /**< \brief (NVMCTRL) OTP2 Base Address */
#define NVMCTRL_OTP4                  (0x00806020UL) /**< \brief (NVMCTRL) OTP4 Base Address */
#define NVMCTRL_TEMP_LOG              (0x00806030UL) /**< \brief (NVMCTRL) TEMP_LOG Base Address */
#define NVMCTRL_USER                  (0x00804000UL) /**< \brief (NVMCTRL) USER Base Address */
#define NVMCTRL_INST_NUM  1                          /**< \brief (NVMCTRL) Number of instances */
#define NVMCTRL_INSTS     { NVMCTRL }                /**< \brief (NVMCTRL) Instances List */

#define PAC0              ((Pac      *)0x40000000UL) /**< \brief (PAC0) APB Base Address */
#define PAC1              ((Pac      *)0x41000000UL) /**< \brief (PAC1) APB Base Address */
#define PAC2              ((Pac      *)0x42000000UL) /**< \brief (PAC2) APB Base Address */
#define PAC_INST_NUM      3                          /**< \brief (PAC) Number of instances */
#define PAC_INSTS         { PAC0, PAC1, PAC2 }       /**< \brief (PAC) Instances List */

#define PM                ((Pm       *)0x40000400UL) /**< \brief (PM) APB Base Address */
#define PM_INST_NUM       1                          /**< \brief (PM) Number of instances */
#define PM_INSTS          { PM }                     /**< \brief (PM) Instances List */

#define PORT              ((Port     *)0x41004400UL) /**< \brief (PORT) APB Base Address */
#define PORT_IOBUS        ((Port     *)0x60000000UL) /**< \brief (PORT) IOBUS Base Address */
#define PORT_INST_NUM     1                          /**< \brief (PORT) Number of instances */
#define PORT_INSTS        { PORT }                   /**< \brief (PORT) Instances List */

#define PTC_GCLK_ID       23
#define PTC_INST_NUM      1                          /**< \brief (PTC) Number of instances */
#define PTC_INSTS         { PTC }                    /**< \brief (PTC) Instances List */

#define RTC               ((Rtc      *)0x40001400UL) /**< \brief (RTC) APB Base Address */
#define RTC_INST_NUM      1                          /**< \brief (RTC) Number of instances */
#define RTC_INSTS         { RTC }                    /**< \brief (RTC) Instances List */

#define SERCOM0           ((Sercom   *)0x42000800UL) /**< \brief (SERCOM0) APB Base Address */
#define SERCOM1           ((Sercom   *)0x42000C00UL) /**< \brief (SERCOM1) APB Base Address */
#define SERCOM_INST_NUM   2                          /**< \brief (SERCOM) Number of instances */
#define SERCOM_INSTS      { SERCOM0, SERCOM1 }       /**< \brief (SERCOM) Instances List */

#define SYSCTRL           ((Sysctrl  *)0x40000800UL) /**< \brief (SYSCTRL) APB Base Address */
#define SYSCTRL_INST_NUM  1                          /**< \brief (SYSCTRL) Number of instances */
#define SYSCTRL_INSTS     { SYSCTRL }                /**< \brief (SYSCTRL) Instances List */

#define TC1               ((Tc       *)0x42001800UL) /**< \brief (TC1) APB Base Address */
#define TC2               ((Tc       *)0x42001C00UL) /**< \brief (TC2) APB Base Address */
#define TC_INST_NUM       2                          /**< \brief (TC) Number of instances */
#define TC_INSTS          { TC1, TC2 }               /**< \brief (TC) Instances List */

#define WDT               ((Wdt      *)0x40001000UL) /**< \brief (WDT) APB Base Address */
#define WDT_INST_NUM      1                          /**< \brief (WDT) Number of instances */
#define WDT_INSTS         { WDT }                    /**< \brief (WDT) Instances List */

#endif /* (defined(__ASSEMBLY__) || defined(__IAR_SYSTEMS_ASM__)) */
/*@}*/

/* ************************************************************************** */
/**  PORT DEFINITIONS FOR SAMD09C13A */
/* ************************************************************************** */
/** \defgroup SAMD09C13A_port PORT Definitions */
/*@{*/

#include "pio/samd09c13a.h"
/*@}*/

/* ************************************************************************** */
/**  MEMORY MAPPING DEFINITIONS FOR SAMD09C13A */
/* ************************************************************************** */

#define FLASH_SIZE            0x2000UL /* 8 kB */
#define FLASH_PAGE_SIZE       64
#define FLASH_NB_OF_PAGES     128
#define FLASH_USER_PAGE_SIZE  64
#define HMCRAMC0_SIZE         0x1000UL /* 4 kB */

#define FLASH_ADDR            (0x00000000u) /**< FLASH base address */
#define FLASH_USER_PAGE_ADDR  (0x00800000u) /**< FLASH_USER_PAGE base address */
#define HMCRAMC0_ADDR         (0x20000000u) /**< HMCRAMC0 base address */
#define HPB0_ADDR             (0x40000000u) /**< HPB0 base address */
#define HPB1_ADDR             (0x41000000u) /**< HPB1 base address */
#define HPB2_ADDR             (0x42000000u) /**< HPB2 base address */
#define PPB_ADDR              (0xE0000000u) /**< PPB base address */

#define DSU_DID_RESETVALUE    0x10040007UL

/* ************************************************************************** */
/**  ELECTRICAL DEFINITIONS FOR SAMD09C13A */
/* ************************************************************************** */


#ifdef __cplusplus
}
#endif

/*@}*/

#endif /* SAMD09C13A_H */
