Yatekii/project-powerline/software/supervisor/Input_handler.py

# TODO: wird alle 30 minuten vom Main angekickt

# imports
from database import session, Strings, strings, String1, string1, String2, string2, String3, string3, Panels, panels
import time
# import quick2wire.i2c as i2c
import serial_interface
import threading

class InputHandler(threading.Thread):

    def __init__(self):
        threading.Thread.__init__(self)
        # 3 seconds read timeout for now
        self.tty = serial_interface.SerialInterface(3, 0xdeadbeef)
        # Issue a call for faulty data after 10 samples; just for simulation purpose
        self.counter = 5

    # function to write a database-item into the strings table
    def write_string_into_database(self, strnumber, strcurrent):
        newcurrent = Strings()
        newcurrent.stringnumber = strnumber
        newcurrent.stringcurrent = strcurrent
        newcurrent.timestamp = time.time()
        session.add(newcurrent)
        session.flush()

    # function to write a database-item into the panles table
    def write_panel_into_database(self, serialnumber, stringnumber, voltage):
        newvoltage = Panels()
        newvoltage.stringnumber = stringnumber
        newvoltage.serialnumber = serialnumber
        newvoltage.voltage = voltage
        newvoltage.timestamp = time.time()
        session.add(newvoltage)
        session.flush()
        #TODO: überprüfen ob sn in stringsx table schon vorhanden falls nicht reinschreiben

    # function to wirte a database item into the string1 table

    # function to wirte a database item into the string2 table
    def write_string2_into_database(self, serialnumber):
        newstringitem = String2()
        newstringitem.serialnumber = serialnumber
        session.add(newstringitem)
        session.flush()

    # function to wirte a database item into the string3 table
    def write_string3_into_database(self, serialnumber):
        newstringitem = String3()
        newstringitem.serialnumber = serialnumber
        session.add(newstringitem)
        session.flush()

    # # function to get the current-values of a string
    # def read_stringcurrents_i2c(self, stringnumber):
    #     address_read = 0b01101001
    #     address_write = 0b01101000
    #     register = 0
    #     if stringnumber == 1:
    #         register = 0b01100011
    #     elif stringnumber == 2:
    #         register = 0b01100101
    #     elif stringnumber == 3:
    #         register = 0b01100111
    #     with i2c.I2CMaster() as bus:
    #         read_results = bus.transaction(i2c.writing_bytes(address_write, register), i2c.reading(address_read, 2))
    #         received_data = read_results[0][0]
    #         # todo check crc
    #         # todo split the currentvalue from the rest of the data to return it
    #     return current
    #
    #
    # # function to get the current voltage of one module
    # def read_modulevoltage_i2c(self, stringnumber, serialnumber):
    #     # TODO: register
    #     register = 0
    #     address_read = 0
    #     address_write = 0
    #     if stringnumber == 1:
    #         address_read = 0b10011011
    #         address_write = 0b10011010
    #     elif stringnumber == 2:
    #         address_read = 0b10011001
    #         address_write = 0b10011000
    #     elif stringnumber == 3:
    #         address_read = 0b10010011
    #         address_write = 0b10010010
    #     with i2c.I2CMaster() as bus:
    #         read_results = bus.transaction(i2c.writing_bytes(address_write, register, bin(serialnumber)), i2c.reading(address_read, 2))
    #         received_data = read_results[0][0]
    #         #todo check CRC
    #         # todo split infos in SN and voltage
    #     return (sn,voltage)

    # function to get the stringcurrents of all 3 strings and write them into the database
    def stringcurrents_request(self):
        stringnumbers = [1, 2, 3]
        for stringnumber in stringnumbers:
            current = read_stringcurrents_i2c(stringnumber)
            # TODO: current in richtige form bringen
            self.write_string_into_database(stringnumber, current)

    # function that compares the sringcurrents and sets a flag if the deviation is too high
    def string_compare(self):
        # creates a list with the latest stringcurrent values for the 3 strings
        # (inserts a zero if there is one a not existing string)
        stringnumbers = [1, 2, 3]
        latestlogs = []
        for stringnumber in stringnumbers:
            results = session.query(Strings).filter(strings.c.stringnumber == stringnumber).all()
            if len(results) == 0:
                latestlogs.append(0)
            else:
                latestlogs.append(results[-1])

        # calculates the average of the existing stringcurrents
        currents = []
        # TODO: Abweichung definieren
        percentage_deviation = 30
        for log in latestlogs:
            currents.append(log.stringcurrent)
        average = (sum(currents))/(sum(1 for e in currents if e)) # ignores the zero if there is one

        # sets the watch flag to all logs with a higher percentage_deviation than chosen
        for log in latestlogs:
            if (log.stringcurrent < average/100*(100-percentage_deviation)) | (log.stringcurrent > average/100*(100+percentage_deviation)):
                log.flag_watch = True
                session.flush()
            else:
                pass

    # function to get the voltages of all the modules in the system and writes them into the database
    def modulevoltage_request(self):
        strings = []
        strings.append(session.query(String1).all())
        strings.append(session.query(String2).all())
        strings.append(session.query(String3).all())

        # Only for simulation purposes
        if self.counter > 0:
            self.counter -= 1;
        else:
            self.counter = 5

        for string_id, string in enumerate(strings):
            if string:
                for item in string:
                    # TODO: change back to i2c; UART only for testing purposes
                    # (sn, voltage) = read_modulevoltage_i2c(1, item.serialnumber)
                    if self.counter > 0:
                        self.tty.request_good_fake_data(item.serialnumber)
                    else:
                        self.tty.request_bad_fake_data(item.serialnumber)
                    voltage = self.tty.wait_for_voltage(item.serialnumber)
                    # TODO: voltage in richtiges format anpassen
                    # TODO: timer auf antwort warten (wie realisieren)
                    # if voltage == 0: #TODO: muss noch angepasst werden
                    # # TODO: if keine antwort
                    #     historycheck = session.query(Panels).filter((panels.c.serialnumber == item.serialnumber) & (panels.c.timestamp > (time.time() - 24*60*60))).all()
                    #     if len(historycheck)==0:
                    #         # TODO: melden auslösen
                    #         pass #zu testzwecken - wieder rausnehmen
                    #     else:
                    #         pass
                    # # TODO: else antwort kommt
                    # else:
                    self.write_panel_into_database(item.serialnumber, string_id + 1, voltage)

                latestlogs = []
                values = []
                for panel in string:
                    result = session.query(Panels).filter(panels.c.serialnumber == panel.serialnumber).order_by(panels.c.timestamp.desc()).first()
                    latestlogs.append(result)
                    values.append(result.voltage)
                avg_value = sum(values) / len(values)
                for log in latestlogs:
                    deviation = avg_value - log.voltage
                    log.deviation = deviation
                    # TODO: remove this ugly demo patch as it just instantly faults an isse when a module drops significantly (could be a 2sec shadow)
                    if(deviation > 0.2 * avg_value):
                        self.issue_fault(log.serialnumber)
                    session.flush()

    def issue_fault(self, serial_number):
        print('FAULT DETECTED', serial_number)
        self.fault_callback(serial_number)

    def set_fault_callback(self, callback):
        self.fault_callback = callback

    def stop(self):
        self.running = False

    def run(self):
        self.running = True
        while self.running:
            self.modulevoltage_request()
            #Wait for 3 Secs, then issue new sample
            time.sleep(3)

# TODO: main sequence:
# stringcurrents_request()
# string_compare()
# input_handler.write_string1_into_database(0xdeadbeef)
# input_handler.write_string1_into_database(0xcafebabe)
# input_handler.write_string1_into_database(0xbadeaffe)
