Yatekii/project-powerline/software/sensor/P0werline/atmel_start.c

/*
 * Code generated from Atmel Start.
 *
 * This file will be overwritten when reconfiguring your Atmel Start project.
 * Please copy examples or other code you want to keep to a separate file
 * to avoid losing it when reconfiguring.
 */

#include "atmel_start.h"
#include <utils.h>
#include <hal_init.h>
#include <hpl_irq.h>
#include <hpl_pm1_v201_base.h>
#include <hpl_gclk1_v210_base.h>
#include <peripheral_gclk_config.h>
#include <hal_usart_async.h>
#include <helpers.h>

#if CONF_DMAC_MAX_USED_DESC > 0
#endif

/*! The buffer size for USART */
#define USART_0_BUFFER_SIZE 16
/*! The buffer size for ADC */
#define ADC_0_BUFFER_SIZE 16

extern struct _irq_descriptor *_irq_table[PERIPH_COUNT_IRQn];
extern void Default_Handler(void);

struct usart_async_descriptor USART_0;
struct adc_async_descriptor ADC_0;

static uint8_t USART_0_buffer[USART_0_BUFFER_SIZE];
static uint8_t ADC_0_buffer[ADC_0_BUFFER_SIZE];

/**
 * \brief USART Clock initialization function
 *
 * Enables register interface and peripheral clock
 */
void USART_0_CLOCK_init()
{
	_pm_enable_bus_clock(PM_BUS_APBC, SERCOM0);
	_gclk_enable_channel(SERCOM0_GCLK_ID_CORE, CONF_GCLK_SERCOM0_CORE_SRC);
	_gclk_enable_channel(SERCOM0_GCLK_ID_SLOW, CONF_GCLK_SERCOM0_SLOW_SRC);
}

/**
 * \brief USART pinmux initialization function
 *
 * Set each required pin to USART functionality
 */
void USART_0_PORT_init()
{
	gpio_set_pin_function(PA04, PINMUX_PA04D_SERCOM0_PAD0);

	gpio_set_pin_function(PA05, PINMUX_PA05D_SERCOM0_PAD1);
}

/**
 * \brief USART initialization function
 *
 * Enables USART peripheral, clocks and initializes USART driver
 */
void USART_0_init(void)
{
	USART_0_CLOCK_init();
	usart_async_init(&USART_0, SERCOM0, USART_0_buffer, USART_0_BUFFER_SIZE);
	USART_0_PORT_init();
}

/**
 * \brief ADC initialization function
 *
 * Enables ADC peripheral, clocks and initializes ADC driver
 */
static void ADC_0_init(void)
{
	_pm_enable_bus_clock(PM_BUS_APBC, ADC);
	_gclk_enable_channel(ADC_GCLK_ID, CONF_GCLK_ADC_SRC);
	adc_async_init(&ADC_0, ADC, ADC_0_buffer, ADC_0_BUFFER_SIZE);
  adc_async_set_resolution(&ADC_0, 12);

	// Disable digital pin circuitry
	gpio_set_pin_direction(PA02, GPIO_DIRECTION_OFF);
	gpio_set_pin_function(PA02, PINMUX_PA02B_ADC_AIN0);
}

void SERCOM0_Handler(void)
{
	if (_irq_table[ SERCOM0_IRQn + 0 ]) {
		_irq_table[ SERCOM0_IRQn + 0 ]->handler(
				_irq_table[ SERCOM0_IRQn + 0 ]->parameter);
	} else {
		Default_Handler();
	}
}
void ADC_Handler(void)
{
	if (_irq_table[ ADC_IRQn + 0 ]) {
		_irq_table[ ADC_IRQn + 0 ]->handler(
				_irq_table[ ADC_IRQn + 0 ]->parameter);
	} else {
		Default_Handler();
	}
}
void DMAC_Handler(void)
{
	if (_irq_table[  +0 ]) {
		_irq_table[  +0 ]->handler(_irq_table[  +0 ]->parameter);
	} else {
		Default_Handler();
	}
}
void SYSCTRL_Handler(void)
{
	if (_irq_table[ SYSCTRL_IRQn + 0 ]) {
		_irq_table[ SYSCTRL_IRQn + 0 ]->handler(
				_irq_table[ SYSCTRL_IRQn + 0 ]->parameter);
	} else {
		Default_Handler();
	}
}
void PM_Handler(void)
{
	if (_irq_table[ PM_IRQn + 0 ]) {
		_irq_table[ PM_IRQn + 0 ]->handler(_irq_table[ PM_IRQn + 0 ]->parameter);
	} else {
		Default_Handler();
	}
}

/**
 * Example of using USART_0 to write "Hello World" using the IO abstraction.
 *
 * Since the driver is asynchronous we need to use statically allocated memory for string
 * because driver initiates transfer and then returns before the transmission is completed.
 *
 * Once transfer has been completed the tx_cb function will be called.
 */

static void tx_cb_USART_0(const struct usart_async_descriptor *const io_descr)
{
	/* Transfer completed */
}

static void rx_cb(const struct usart_async_descriptor *const io_descr)
{
	/* Receive completed */
}

static void err_cb(const struct usart_async_descriptor *const io_descr)
{
	/* Error occurred */
}

static void convert_cb_ADC_0(const struct adc_async_descriptor *const descr)
{

}

void USART_setup(void){
  usart_async_register_callback(&USART_0, USART_ASYNC_TXC_CB, tx_cb_USART_0);
	usart_async_register_callback(&USART_0, USART_ASYNC_RXC_CB, rx_cb);
	usart_async_register_callback(&USART_0, USART_ASYNC_ERROR_CB, err_cb);
}

/**
 * Example of using ADC_0 to generate waveform.
 */
void ADC_0_example(void)
{
	adc_async_register_callback(&ADC_0, ADC_ASYNC_CONVERT_CB, convert_cb_ADC_0);
	adc_async_enable(&ADC_0);
	adc_async_start_conversion(&ADC_0);
}

void system_init(void)
{
	init_mcu();

	// GPIO on PA14

	// Set pin direction to output
	gpio_set_pin_direction(LED_RED, GPIO_DIRECTION_OUT);

	gpio_set_pin_level(LED_RED,
	        // <y> Initial level
	        // <id> pad_initial_level
	        // <false"> Low
	        // <true"> High
			true);

	gpio_set_pin_function(LED_RED, GPIO_PIN_FUNCTION_OFF);

	// GPIO on PA15

	// Set pin direction to output
	gpio_set_pin_direction(LED_GREEN, GPIO_DIRECTION_OUT);

	gpio_set_pin_level(LED_GREEN,
	        // <y> Initial level
	        // <id> pad_initial_level
	        // <false"> Low
	        // <true"> High
			true);

	gpio_set_pin_function(LED_GREEN, GPIO_PIN_FUNCTION_OFF);

	USART_0_init();
	ADC_0_init();
}
