Yatekii/project-powerline/software/sensor/include/conf_usart.h

// This file is required by ASF

#ifndef CONF_SPI_H_INCLUDED
#  define CONF_SPI_H_INCLUDED

#  define CONF_SPI_MASTER_ENABLE     true
#  define CONF_SPI_SLAVE_ENABLE      true

#endif /* CONF_SPI_H_INCLUDED */
