Yatekii/project-powerline/software/supervisor/emitter.py

import socket
import json


TCP_IP = '127.0.0.1'
TCP_PORT = 1337

s = socket.socket(socket.AF_INET, socket.SOCK_STREAM)
s.connect((TCP_IP, TCP_PORT))

msg = {
    'error': {
            'id': 0xdeadbeef
        }
}

print('Sending:')
print(msg)

s.send(json.dumps(msg).encode())
s.close()
