Yatekii/project-powerline/(commit log)

2016-03-07 Added symbols for SAMD09 and SM72485 and footprint for SM72485
    [sensor.kicad_pcb, sensor.sch]
2016-03-07 Finished Modulator; still needs Values doe; Fixed Symbol for the HC4046
    [sensor.sch]
2016-03-09 Finished Demodulator without fiex values
    [sensor.sch]
2016-03-09 Finished LDO for 3V3
    [sensor.sch]
2016-03-09 Changed sensor sim
2016-03-10 Started SAM D09 schematic
    [modem_AFE031.sch, modem_TDA5051A.sch, sensor.sch]
2016-03-11 Started redoing buck; added LMR16006 component
    [modem_AFE031.sch, modem_TDA5051A.sch, sensor.sch]
2016-03-12 New buck schema is done
    [sensor.sch]
2016-03-13 Added trimmer to adjust the frequency range; Needs amp and SAMD09
    [sensor.sch]
2016-03-13 Finished schema for prototype; Started placing of the parts; BUCK and TX done
    [sensor.sch]
2016-03-14 Fixed some schematic mistakes and footprints. Continued placing parts.
    [sensor.kicad_pcb, sensor.sch]
2016-03-14 Finished placing for now
    [_saved_sensor.sch, sensor.kicad_pcb]
2016-03-14 Routing started. VCC and GND still need routing. Probably need to lower density of parts for a proper groundplane ...
    [sensor.kicad_pcb]
2016-03-15 Finished routing except GND (needs plane etc pp); VCC and maybe even 3V3 needs thicker traces; Fixed missing supply cap for SAMD09 in the schema as well as some wrong footprint for SWD
    [_saved_sensor.sch, sensor.kicad_pcb, sensor.sch]
2016-03-15 Nearly done routing. DRC needs to be consulted!
    [_saved_sensor.sch]
2016-03-16 Done routing. Some DRC fails but that should be ok!
    [sensor.kicad_pcb]
2016-03-16 Bottom layer labels arranged
    [_saved_sensor.sch, sensor.kicad_pcb, sensor.sch]
2016-03-16 Top layer labels arranged
    [sensor.kicad_pcb]
2016-03-16 Added Gerber files
    [sensor-B.CrtYd.gbr, sensor-B.Cu.gbr, sensor-B.Mask.gbr, sensor-B.SilkS.gbr, sensor-Edge.Cuts.gbr, sensor-F.CrtYd.gbr, sensor-F.Cu.gbr, sensor-F.Mask.gbr]
2016-03-16 moved sensor schematic/layout
    [modem_AFE031.sch, modem_TDA5051A.sch, sensor.kicad_pcb, sensor.sch]
2016-03-16 Cleanup of files; hope this works now
    [sensor-B.CrtYd.gbr, sensor-B.Cu.gbr, sensor-B.Mask.gbr, sensor-B.SilkS.gbr, sensor-Edge.Cuts.gbr, sensor-F.CrtYd.gbr, sensor-F.Cu.gbr, sensor-F.Mask.gbr]
2016-03-16 Cleanup seems done
    [sensor-B.CrtYd.gbr, sensor-B.Cu.gbr, sensor-B.Mask.gbr, sensor-B.SilkS.gbr, sensor-Edge.Cuts.gbr, sensor-F.CrtYd.gbr, sensor-F.Cu.gbr, sensor-F.Mask.gbr]
2016-03-16 Cleanup should be right now ...
    [modem_AFE031.sch, modem_TDA5051A.sch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]
2016-03-16 added relay to lib and removed backup file
2016-03-16 Initial commit of supervisor hardware and gsm library
    [supervisor.kicad_pcb, supervisor.sch]
2016-03-22 Added ZXGD3005E6 Gate Driver to Libs; Added Gate Driver to FET
    [sensor.sch]
2016-03-23 Routing done with Gate Driver. Testpoints are left for now.
    [sensor.kicad_pcb, sensor.sch]
2016-03-24 Verpolungsschutz zemebastlet^
    [sensor.sch]
2016-03-24 libary mosfet ond soo
2016-03-24 Added footprints; started layouting of the new parts
    [sensor.kicad_pcb]
2016-03-24 Done routing
    [sensor.kicad_pcb, sensor.sch]
2016-03-24 reworked master, added interface elements
    [supervisor.sch]
2016-03-25 added 3V3 supply, logic shifter and more
    [supervisor.sch]
2016-03-25 added ADC and cleaned up
    [supervisor.sch]
2016-03-26 added gsm footprints and started master layout
    welcome to layouting hell
    [supervisor.kicad_pcb, supervisor.sch]
2016-03-26 master pcb work
    [supervisor.kicad_pcb, supervisor.sch]
2016-04-01 Added missing 3v3 trace
    [sensor.kicad_pcb]
2016-04-01 Removed two dead vias and updated gerber files
    [sensor-B.CrtYd.gbr, sensor-B.Cu.gbr, sensor-B.Mask.gbr, sensor-B.SilkS.gbr, sensor-Edge.Cuts.gbr, sensor-F.CrtYd.gbr, sensor-F.Cu.gbr, sensor-F.Mask.gbr]
2016-04-02 Fixed a bug in the Makefile where object files would be placed in the wrong location
    [main.c]
2016-04-02 ignore arm binaries
2016-04-02 Added frameworks; makefile sadly doesn't compile yet ...
    [asf.h, main.c, uart.c, uart.h]
2016-04-09 Adjusted 2-3 things in the schema.
    [sensor.sch]
2016-04-11 Altered Makefile to support all rules now; First successful flash of the program; leds blink now
2016-04-11 LEDs now blink NICELY!
2016-04-11 Added openocd cfg
    [atsamd09.cfg]
2016-04-11 updated circle.yml from software-sensor
2016-04-11 Added sample code for GPIO. Doesn't work yet because of a hardware bug
    [main.c]
2016-04-12 moved FSK part of schematic to subsheet. needs cleanup
    [powerline-fsk.sch, sensor.sch]
2016-04-12 added fsk-module to master
    [powerline-fsk.sch, supervisor.sch]
2016-04-14 Fixed push button and added debouncing
    [sensor.kicad_pcb, sensor.sch]
2016-04-15 started using uart
2016-04-21 Got uart TX working
2016-05-04 Fixed -Wall to -Werror in Makefile; coded adc part (I am sure it's not working to be honest)
    [adc_toolset.c, helpers.c, main.c, uart.c]
2016-05-04 Tried to get adc/uart working; added Atmel.start code to try with that
    [atsamd09.cfg]
2016-05-05 UART works nice now; stores text in buffer; need to implement commands
2016-05-05 Simulations
    - receiver: clamp circuit
    - transmitter
    On branch master
    Your branch is up-to-date with 'origin/master'.
    Changes to be committed:
    new file: doc/simu/fetsim.asc
    new file: doc/simu/fetsim.op.raw
    new file: doc/simu/fetsim.raw
    new file: doc/simu/receiver_master.asc
    new file: doc/simu/receiver_master.net
    new file: doc/simu/receiver_master.op.raw
    new file: doc/simu/receiver_master.plt
    new file: doc/simu/receiver_master.raw
2016-05-05 UART works awesome; ADC not :(
2016-05-06 Page Margins
    spine = 1/7 * paperwidth (30 mm, for binding w/ ringbinder)
    edge = 1.5 * spine (45 mm)
    top = 1/9 * paperheight (33 mm same as in isopage)
    bottom = 1.5 * top (50 mm)
    On branch latex
    Your branch is up-to-date with 'origin/latex'.
    modified: ../fb_fhnwreport/fachbericht.pdf
    modified: ../fb_fhnwreport/sections/einleitung.tex
    modified: chapters/einleitung.tex
    modified: chapters/firmware.tex
    modified: chapters/hardware.tex
    new file: data/fetsim.dat
    modified: main.tex
    modified: preamble/a3pages.tex
    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
2016-05-09 created branch, added i2c map
2016-05-09 Fixed errors with pll
    [sensor.sch]
2016-05-09 lost changes to pll ...
    [sensor.sch]
2016-05-10 Removed faulty project stuff in kicad
    [powerline-fsk.sch]
2016-05-10 Circuits: Inductive Coupling
    modified: .gitignore
    new file: images/circuits/coupling-inductive.tex
    modified: main.ctr
    modified: preamble/packages.tex
    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
2016-05-10 Fetsim Circuit
    modified: images/circuits/coupling-inductive.tex
    new file: images/circuits/fetsim.tex
    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
2016-05-10 first prototype of threaded master-software
2016-05-10 updated prototype, fixed flake8 complaints
    [main.py, threadtest.py]
2016-05-10 fixing master schema
    [powerline-fsk.sch, supervisor.sch]
2016-05-10 Simu for Docs
    modified: bibliography/references.bib
    new file: data/measurement-inductor-1layer-Rseries.dat
    new file: data/measurement-inductor-1layer-inductance.dat
    new file: images/circuits/solarCell.tex
    new file: images/ltspice/solarmodul-zellenbasiert-eps-converted-to.pdf
    new file: images/ltspice/solarmodul-zellenbasiert.eps
    new file: ../simulations/fetsim.asc
    new file: ../simulations/fetsim.op.raw
    new file: ../simulations/fetsim.raw
    new file: ../simulations/fetsim2.asc
    new file: ../simulations/fetsim2.eps
    ne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
2016-05-10 Userguide: Separate Chapter
    modified: chapters/uberblick.tex
    new file: chapters/userguide.tex
    modified: images/circuits/solarCell.tex
    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
2016-05-11 update raspi connections
    [powerline-fsk.sch, supervisor.sch]
2016-05-11 actually connect i2c
    [supervisor.sch]
2016-05-11 fixed master fsk circuit, replaced discrete crystals with raspi clock
    [powerline-fsk.sch, supervisor.sch]
2016-05-11 PCB and schematic V2
    [sensor.kicad_pcb, sensor.sch]
2016-05-11 diodeVI plot
2016-05-11 added coupling connectors
    [supervisor.sch]
2016-05-11 More Simu Stuff
    new file: appendices/celldata.tex
    new file: images/python/diodeVI.pgf
    modified: ../simulations/fetsim2.asc
    modified: ../simulations/fetsim2.op.raw
    modified: ../simulations/fetsim2.raw
    new file: ../simulations/module-72cells.asc
    new file: ../simulations/module-72cells.net
    new file: ../simulations/module-72cells.op.raw
    new file: ../simulations/module-72cells.raw
    modified: ../simulations/singlecell.asc
    new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
2016-05-11 PCB Bugfixes
    R,C under switch removed
    [sensor.kicad_pcb]
2016-05-11 Gerber_Data and small fixes
    [sensor.kicad_pcb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]
2016-05-11 update fskmodule schematic
    [fskmodule.sch, powerline-fsk.sch, supervisor.sch]
2016-05-11 lots of cleaning up, added no-connects
    [supervisor.sch]
2016-05-11 update current ADC
    [supervisor.sch]
2016-05-11 Diode Equation, Diode IV Curve Tuning
    modified: images/python/diodeVI.pgf
    modified: python/diodeVI.py
    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
2016-05-11 updated helper files and generated new pcb
    [fskmodule.sch, supervisor.kicad_pcb, supervisor.sch]
2016-05-11 removed dead traces
    [supervisor.kicad_pcb]
2016-05-12 switch to semaphores for signaling, quit threads as daemons
2016-05-12 add support for chaining thread executions
2016-05-12 Simu Progress and Cleanup
    new file: ../fb_memoir/appendices/simu-modul.tex
    modified: ../fb_memoir/chapters/hardware.tex
    new file: ../fb_memoir/images/circuits/moduleMOSFET.tex
    modified: ../fb_memoir/images/circuits/solarCell.tex
    new file: ../fb_memoir/images/ltspice/module-72cells-eps-converted-to.pdf
    renamed: fetsim2.ps -> ../fb_memoir/images/ltspice/module-72cells.eps
    new file: ../fb_memoir/images/ltspice/singlecell-eps-converted-to.pdf
    new file: ../fb_memoir/images/ltspice/singlecell.eps
    deleted: ../fb_memoir/images/ltspice/solarmodul-zellenbasiert-eps-converted-to.pdf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
2016-05-12 create pcb outline for master
    [supervisor.kicad_pcb]
2016-05-12 Simulation: 72-Cell Module
    new file: data/module-72cells--I-MOSFET--0005u.dat
    new file: data/module-72cells--I-MOSFET--0010u.dat
    new file: data/module-72cells--I-MOSFET--0070u.dat
    new file: data/module-72cells--I-MOSFET--1000u.dat
    new file: data/module-72cells--P-MOSFET--0005u.dat
    new file: data/module-72cells--P-MOSFET--0010u.dat
    new file: data/module-72cells--P-MOSFET--0070u.dat
    new file: data/module-72cells--P-MOSFET--1000u.dat
    new file: data/module-72cells--U-MOSFET--0005u.dat
    new file: data/module-72cells--U-MOSFET--0010u.dat
    new f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
2016-05-12 restart layouting
    [supervisor.kicad_pcb]
2016-05-12 Update master schematic
    [fskmodule.sch, supervisor.sch]
2016-05-12 Footprint Relay serie 36
2016-05-12 Update Relay
    [supervisor.sch]
2016-05-12 fix fsk-modules
    [fskmodule_1.sch, fskmodule_2.sch, fskmodule_3.sch, supervisor.sch]
2016-05-12 fix pcb-changes
    [supervisor.kicad_pcb]
2016-05-12 Simple Module Model
    new file: appendices/simu-modul-simple.tex
    new file: data/module-72cells--P-MOSFET--0002u--average.txt
    new file: data/module-72cells--P-MOSFET--0010u--average.txt
    new file: data/module-72cells--P-MOSFET--1000u--average.txt
    new file: ../simulations/module-72cells-template.asc
    deleted: ../simulations/module-72cells.net
    new file: ../simulations/module-simple.asc
    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
2016-05-12 swap adc package
    [supervisor.kicad_pcb]
2016-05-12 ordered master footprints
    [supervisor.kicad_pcb]
2016-05-12 Worked on sensor firmware .
2016-05-13 fixed modules
    [fskmodule_1.sch, fskmodule_2.sch, fskmodule_3.sch, supervisor.kicad_pcb, supervisor.sch]
2016-05-13 Print troubleshooting
    +newest Gerberfiles
    [sensor.kicad_pcb, sensor.sch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]
2016-05-13 updated poti library from sensor libraries
    [fskmodule_1.sch, fskmodule_2.sch, fskmodule_3.sch, supervisor.kicad_pcb, supervisor.sch]
2016-05-13 change PLL ic to thinner footprint
    [fskmodule_1.sch, fskmodule_2.sch, fskmodule_3.sch, supervisor.kicad_pcb]
2016-05-13 replace 3 leds with SMT
    [supervisor.kicad_pcb, supervisor.sch]
2016-05-13 UART buffer is now read properly and parses command when '\r' is sent
2016-05-13 prepare threading class for usage
2016-05-13 Redesign of the GUI
    implemented all GUI functions
    one unsolved problem: switch window from the methods (idea commented)
    [GUI.py, test.py]
2016-05-13 fixed some database communication
    [database.py, receiver.py]
2016-05-13 Simu Series 72 cells, Python line width
    Simulated 72 cell series module, changed line width
    in Python plots.
    new file: appendices/simu-complementary.tex
    modified: appendices/simu-modul.tex
    modified: chapters/simu.tex
    modified: data/module-72cells--I-MOSFET--0005u.dat
    modified: data/module-72cells--P-MOSFET--0005u.dat
    modified: data/module-72cells--U-MOSFET--0005u.dat
    new file: data/module-72cells-series--I-MOSFET--0003u.dat
    new file: data/module-72cells-series--I-MOSFET--1000u.dat
    new file: data/module-72cells-series--P-MOSFET--0003u.dat
    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
2016-05-14 Restructuring
    modified: fb_memoir/appendices/celldata.tex
    new file: fb_memoir/appendices/models.tex
    modified: fb_memoir/appendices/simu-complementary.tex
    modified: fb_memoir/chapters/hardware.tex
    modified: fb_memoir/chapters/simu.tex
    modified: fb_memoir/chapters/uberblick.tex
    modified: fb_memoir/main.ctr
    modified: fb_memoir/main.tex
    modified: simulations/.gitignore
    new file: simulations/ifaulty.pwl
    new file: simulations/inductive-coupling.asc
    new file: simulations/module-72cells-series--rshunt-param.asc
    modified: simulations/module-72cells-series-failure.asc
    mod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
2016-05-14 Inductive coupling
    Your branch is behind 'origin/latex' by 2 commits, and can be fast-forwarded.
    (use "git pull" to update your local branch)
    new file: ../simulations/inductive-coupling.asc
    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
2016-05-14 diode plot update
2016-05-16 Simple Cell Verification For 72x1
    modified: appendices/models.tex
    modified: appendices/simu-modul-simple.tex
    new file: data/simple-model-verification/module-72cells-series--reference--freq-sweep-over-Rload--100ohm-100uF--I--magn.dat
    new file: data/simple-model-verification/module-72cells-series--reference--freq-sweep-over-Rload--100ohm-100uF--I--phase.dat
    new file: data/simple-model-verification/module-72cells-series--reference--freq-sweep-over-Rload--100ohm-100uF--I.dat
    new file: data/simple-model-verification/module-72cells-series--reference--freq-sweep-over-mosfet-no-load--I--magn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
2016-05-17 Models: Cleanup, Restructuring
    modified: appendices/celldata.tex
    new file: images/circuits/solarCellParams.tex
    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
2016-05-18 Improved Circuits, more info on simple module
    modified: appendices/ltspice.tex
    new file: images/ltspice/module-72cells--36x2-eps-converted-to.pdf
    new file: images/ltspice/module-72cells--36x2.eps
    new file: images/ltspice/module-72cells--72x1-eps-converted-to.pdf
    new file: images/ltspice/module-72cells--72x1.eps
    new file: images/ltspice/module-simple-72x1-eps-converted-to.pdf
    copied: images/ltspice/singlecell.eps -> images/ltspice/module-simple-72x1.eps
    new file: images/ltspice/module-test-circuit-with-load-eps-converted-to.pdf
    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
2016-05-18 module: simplified circuit diagrams
2016-05-19 Magic progress in database communication
    [netz_test.kicad_pcb, netz_test.sch]
2016-05-19 prototype layout for fsk
    [supervisor.kicad_pcb]
2016-05-19 Footprint connector-coupling
2016-05-19 updated footprint connectors
2016-05-20 Fixes LTSpice Circuit for VI Curve
    new file: images/ltspice/module-string-complete-eps-converted-to.pdf
    new file: images/ltspice/module-string-complete.eps
    modified: ../simulations/72x1--complete-circuit--iv-curve/module-string-complete.asc
    new file: ../simulations/72x1--complete-circuit--iv-curve/module-string-complete.eps
    new file: ../simulations/72x1--complete-circuit--iv-curve/module-string-complete.svg
    new file: ../simulations/72x1--complete-circuit--iv-curve/module-string-complete.wmf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
2016-05-21 IV-Curves: Adds Power Plots
    Compiling is starting to take veeeeery long...
    modified: data/iv-curves/module-string-complete--all-ok.dat
    modified: data/iv-curves/module-string-complete--ifail-1A.dat
    modified: data/iv-curves/module-string-complete--ifail-5A.dat
    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
2016-05-21 Improved Solar Cell Model
    This should be the final model of the PV cell.
    But, TODO:
    - Redo all simulations
    - Rewrite all the text
    modified: ../simulations/.gitignore
    deleted: ../simulations/36x2/module-72cells--36x2.wmf
    deleted: ../simulations/36x2/module-72cells.asc
    deleted: ../simulations/72x1--complete-circuit--fsk--inductive/module-string--short-circuit--receiver.dat
    deleted: ../simulations/72x1--complete-circuit--fsk--inductive/module-string-complete.asc
    deleted: ../simulations/72x1--complete-circuit--iv-curve/72series.wmf
    deleted: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
2016-05-22 ASK schematic
    Changed Rx circuit and Tx small changes…
    [sensor.sch]
2016-05-22 Cell -> Module -> String Pics
    Your branch is ahead of 'origin/latex' by 1 commit.
    (use "git push" to publish your local commits)
    modified: ../../appendices/commercial-modules.tex
    modified: ../../chapters/simu.tex
    modified: ../../chapters/uberblick.tex
    modified: ../circuits/solarCell.tex
    new file: Silicon_solar_cell_(PERC)_front_and_back.jpg
    new file: Silicon_solar_cell_(PERC)_front_and_back.txt
    new file: cell--400px.png
    new file: cell.jpeg
    new file: module-terminals.jpeg
    new file: module-terminals.png
    new file: module.jpeg
    new file: module.png
    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
2016-05-22 PCB V3 and schematic updated
    s: added FET
    PCB: ASK added DRC still outstanding
    [_saved_sensor.sch, sensor.kicad_pcb]
2016-05-22 backport changes in sensor to master
    [fskmodule_1.sch, fskmodule_2.sch, fskmodule_3.sch, supervisor.sch]
2016-05-22 split 3V3 nets, added 230V connector
    [supervisor.sch]
2016-05-22 remove unused schematic parts, port changes to master pcb
    [fskmodule_1.sch, fskmodule_2.sch, fskmodule_3.sch, supervisor.kicad_pcb, supervisor.sch]
2016-05-23 master grouping done
    [fskmodule_1.sch, fskmodule_2.sch, fskmodule_3.sch, supervisor.kicad_pcb, supervisor.sch]
2016-05-23 routing 0.1
    [supervisor.kicad_pcb]
2016-05-23 routing 0.2
    [supervisor.kicad_pcb]
2016-05-23 routing 1.0 to review
    [supervisor.kicad_pcb]
2016-05-24 routing 1.1 to release
    [supervisor.kicad_pcb]
2016-05-25 Hardware: Master
    General descriptions.
    new file: appendices/schema.tex
    new file: images/superv-pcb/supervisor-3d-1.png
    new file: images/superv-pcb/supervisor-3d-2.png
    new file: images/superv-photos/dinrail-cover.jpeg
    new file: images/superv-photos/dinrail.jpeg
    new file: images/superv-photos/master.jpeg
    new file: images/superv-photos/raspi-1.jpeg
    new file: images/superv-sch/supervisor--sch--comms-eps-converted-to.pdf
    new file: images/superv-sch/supervisor--sch--comms.eps
    new file: images/superv-sch/sup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
2016-05-25 Sensor Schema
    new file: images/sensor-pcb/sensor-3d-back.png
    new file: images/sensor-pcb/sensor-3d-front.png
    new file: images/sensor-sch/sensor--sch--highlights-eps-converted-to.pdf
    new file: images/sensor-sch/sensor--sch--highlights.eps
    new file: images/sensor-sch/sensor--sch--interface-eps-converted-to.pdf
    new file: images/sensor-sch/sensor--sch--interface.eps
    new file: images/sensor-sch/sensor--sch--mcu-eps-converted-to.pdf
    new file: images/sensor-sch/sensor--sch--mcu.eps
    new file: images/sensor-sch/sensor--sch--receiver-eps-converted-to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
2016-05-26 soo eigentlich gloub ke grossi änderige...
    [_saved_sensor.sch, sensor.kicad_pcb, sensor.sch]
2016-05-26 supervisior bugfixes final
    [supervisor.kicad_pcb]
2016-05-26 Sensor fixes
    [sensor-B.Cu.gbr, sensor-B.Mask.gbr, sensor-B.SilkS.gbr, sensor-Edge.Cuts.gbr, sensor-F.Cu.gbr, sensor-F.Mask.gbr, sensor-F.SilkS.gbr, sensor-NPTH.drl]
2016-05-28 Blabla for PV Cell Model
    modified: appendices/schema.tex
    new file: images/circuits/solarCell-1d.tex
    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
2016-05-29 PV Curves: Conditional Calculations
    Only calculates power from I and V if the results files do
    not exist yet, otherwise reads results table from file and
    proceeds. Saves a crapload of compile time.
    modified: data/iv-curves/calculations.tex
    new file: data/iv-curves/module-72cells-series--reference--all-ok--power.dat
    new file: data/iv-curves/module-72cells-series--reference--ifail-1A--power.dat
    new file: data/iv-curves/module-72cells-series--reference--ifail-5A--power.dat
    new file: data/iv-curves/module-string-complete--all-ok--power.dat
    new file: data/iv-curves/module-string-comp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
2016-05-30 Sim Files, Title Signal
    new file: data/short-circuit/module-1ms/jac--m5sf-2--module--mosfet--tran-1ms--Imosfet.dat
    new file: data/short-circuit/module-1ms/jac--m5sf-2--module--mosfet--tran-1ms--Pmosfet.dat
    new file: data/short-circuit/module-1ms/jac--m5sf-2--module--mosfet--tran-1ms--Vmosfet.dat
    new file: data/short-circuit/module-5us/jac--m5sf-2--module--mosfet--tran-5us--Imosfet.dat
    new file: data/short-circuit/module-5us/jac--m5sf-2--module--mosfet--tran-5us--Pmosfet.dat
    new file: data/short-circuit/module-5us/jac--m5sf-2--module--mosfet--tran-5us--Vmosfet.dat
    new file: images/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
2016-06-01 Bypass Diodes
    new file: data/iv-curves/generic-array-bypass/iv-generic-bypass--1a.dat
    new file: data/iv-curves/generic-array-bypass/iv-generic-bypass--4a.dat
    new file: data/iv-curves/generic-array-bypass/iv-generic-bypass--7a.dat
    new file: data/iv-curves/generic-array-bypass/iv-generic-bypass--9a.dat
    new file: data/iv-curves/generic-array-bypass/iv-generic-bypass--full-dataset.dat
    new file: data/iv-curves/generic-array-bypass/jac--m5sf-2--array--bypass.txt
    new file: images/iv-curves/array-bypass-2d.tex
    new fi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
2016-06-01 Models: Mostly Done
    new file: bibliography/IEEEtran_bst_HOWTO.pdf
    new file: bibliography/IEEEtran_bst_HOWTO.txt
    new file: images/capa/capa-hegedus-1.png
    new file: images/capa/capa-hegedus-2.png
    new file: images/capa/capa-mauk.png
    new file: images/capa/capa-scofield.png
    modified: images/circuits/module72x1-simplified.tex
    new file: images/circuits/modulestring.tex
    new file: images/solar-facility/pvmodule-wiring.jpeg
    new file: images/solar-facility/pvmodule-wiring.tex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
2016-06-01 progress capacitive
2016-06-01 Simu: Capacitive, Short-Circuit Partial
    new file: data/capacitive/capacitive--rload-0001.dat
    new file: data/capacitive/capacitive--rload-0010.dat
    new file: data/capacitive/capacitive--rload-0100.dat
    new file: data/capacitive/capacitive--rload-1000.dat
    new file: data/capacitive/capacitive-Cload.dat
    new file: data/short-circuit/shortcircuit-single.dat
    new file: images/circuits/coupling-capacitive.tex
    new file: images/ltspice/jac/capacitive-Cload-eps-converted-to.pdf
    new file: images/ltspice/jac/capacitive-Cload.eps
    new file: images/ltspice/jac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
2016-06-02 Induciton for Noah
    modified: ../../../fb_memoir/chapters/simu.tex
    modified: ../../../fb_memoir/images/ltspice/jac/capacitive-eps-converted-to.pdf
    modified: ../../../fb_memoir/images/ltspice/jac/capacitive.eps
    modified: ../../../fb_memoir/images/simu-capacitive/tran.tex
    modified: ../../../fb_memoir/main.ctr
    modified: ../../../fb_memoir/main.tex
    modified: capacitive.asc
    modified: capacitive.wmf
    new file: inductive-singleModule.asc
    new file: inductive-verySimple.asc
    modified: inductive.asc
    modified: shortcircuit.asc
    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
2016-06-02 Sync Push
    Various simulation stuff
    new file: ../../../fb_memoir/data/capacitive/capacitive-stringEnd.dat
    new file: ../../../fb_memoir/data/capacitive/capacitive-stringStart.dat
    new file: L.svg
    new file: capacitive.eps
    new file: capacitive.svg
    new file: shortcircuit.eps
    new file: shortcircuit.svg
    new file: shortcircuit.wmf
    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
2016-06-02 Simulations: Fiddling around w/ Short Circuit
    modified: images/ltspice/jac/capacitive-eps-converted-to.pdf
    modified: images/ltspice/jac/capacitive.eps
    modified: images/ltspice/jac/shortcircuit-single-eps-converted-to.pdf
    modified: images/ltspice/jac/shortcircuit-single.eps
    modified: ../simulations/jac--m5sf-2/block/capacitive.eps
    modified: ../simulations/jac--m5sf-2/block/capacitive.svg
    modified: ../simulations/jac--m5sf-2/block/jacModule.asc
    new file: ../simulations/jac--m5sf-2/block/shortcircuit-cells.asc
    modified: ../simulations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
2016-06-03 short circuit: fixed stuff
2016-06-04 Short-Circuit
    Mostly documented.
    deleted: data/iv-curves/jac/step.pdf
    new file: data/short-circuit/shortcircuit--10ohm-100nF.dat
    new file: data/short-circuit/shortcircuit-Cload-100n.dat
    new file: data/short-circuit/shortcircuit-Cload-10n.dat
    new file: data/short-circuit/shortcircuit-Cload-10u.dat
    new file: data/short-circuit/shortcircuit-Cload-1n.dat
    new file: data/short-circuit/shortcircuit-Cload-1u.dat
    new file: data/short-circuit/shortcircuit-Cload-steps.dat
    new file: data/short-circuit/shortcircuit-Rload-10.dat
    new file: data/short-cir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
2016-06-06 Simu: Main Part Done
    new file: data/inductive/inductive-CloadRload-stepped.dat
    new file: data/inductive/inductive-resonance.dat
    new file: data/inductive/inductive-singleModule.dat
    new file: data/inductive/steps.txt
    modified: images/circuits/moduleMOSFET.tex
    new file: images/inductive/toroid.tex
    new file: images/ltspice/inductive-singleModule.png
    new file: images/ltspice/jac/inductive-eps-converted-to.pdf
    new file: images/ltspice/jac/inductive-singleModule-ep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
2016-06-08 New IV/PV Curves, New LTspice Schematics
    new file: data/iv-curves/jac/string-IV-001pc-050pc.dat
    new file: data/iv-curves/jac/string-IV-001pc-075pc.dat
    new file: data/iv-curves/jac/string-IV-001pc-100pc.dat
    new file: data/iv-curves/jac/string-IV-043pc-050pc.dat
    new file: data/iv-curves/jac/string-IV-065pc-100pc.dat
    new file: data/iv-curves/jac/string-IV-100pc-100pc.dat
    new file: data/iv-curves/jac/string-IV.dat
    new file: data/iv-curves/jac/stringNoD-IV-001pc.dat
    new file: da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
2016-06-08 Scope Shots
    new file: appendices/validierung.tex
    modified: chapters/validierung.tex
    new file: images/fsk-meas/frequency_sweep_Ls.pgf
    new file: images/fsk-meas/frequency_sweep_Rs.pgf
    new file: images/fsk-meas/power_choke_I.pgf
    new file: images/fsk-meas/power_choke_SUdt.pgf
    modified: images/iv-curves/array-bypass-2d.tex
    new file: images/scopeShots/scope_0.png
    new file: images/scopeShots/scope_0.txt
    new file: images/scopeShots/scope_1.png
    new file: images/scopeShots/scope_1.txt
    new file: images/scopeShots/scope_6.png
    new file: images/scopeShots/scope_6.txt
    new file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
    [1_layer_power_choke_test.csv, 1_layer_power_choke_test_zoom.csv]
2016-06-09 Sensor: Separate Files
    new file: chapters/firmware-sensor.tex
    new file: chapters/hardware-sensor.tex
    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
2016-06-10 Data Flow
    new file: dataFlow.tex
    new file: dataFlowStandalone.tex
    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
2016-06-10 Added a trigger functionality for errors
    [GUI.py, emitter.py, reporter.py]
2016-06-10 Software Sensor done; needs checking and refining; not sure if ok
2016-06-10 Refined Software Sensor
2016-06-10 Changes in the GUI
    Fixed a problem with changing the menu vies
    [GUI.py]
2016-06-10 sensor flow diagram
2016-06-10 sensor flow diagram: udpate
2016-06-10 Hardware Sensor halfways done
2016-06-11 Hardware Sensor nearly done
2016-06-12 Software Master
    Francesco's Stuff and Reto's GUI doc.
    modified: appendices/commercial-modules.tex
    modified: appendices/validierung.tex
    modified: chapters/firmware-sensor.tex
    modified: mastersoftware.md
    modified: preamble/macros.tex
    modified: preamble/memoir.tex
    modified: titlepage/titlepage.tex
    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
2016-06-12 CD, LTspice paths
    Adds CD folder and paths in report to LTspice files.
    new file: ../CD/ltspice/capacitive/capacitive.asc
    new file: ../CD/ltspice/capacitive/jacModule.asc
    new file: ../CD/ltspice/capacitive/jacModule.asy
    new file: ../CD/ltspice/generic/cell-9A.asc
    new file: ../CD/ltspice/generic/module-9A.asc
    new file: ../CD/ltspice/inductive/jacModule.asc
    new file: ../CD/ltspice/inductive/jacModule.asy
    new file: ../CD/ltspice/inductive/singleModule.asc
    new file: ../CD/ltspice/inductive/string.asc
    new file: ../CD/ltspice/jac/jac-cell.asc
    new file: ../CD/ltspice/jac/jacM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
2016-06-12 chapters -> mainmatter
    Reorganising Files
    renamed: masterselect.bib -> ../arbeitspakete/masterselect.bib
    new file: ../arbeitspakete/masterselect.pdf
    renamed: masterselect.tex -> ../arbeitspakete/masterselect.tex
    renamed: mastersoftware.md -> ../arbeitspakete/mastersoftware.md
    renamed: rcl.txt -> ../arbeitspakete/rcl.txt
    renamed: chapters/einleitung.tex -> mainmatter/einleitung.tex
    renamed: chapters/fazit.tex -> mainmatter/fazit.tex
    renamed: chapters/firmware-sensor.tex -> mainmatter/firmware-sensor.tex
    renamed: chapters/ha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
2016-06-14 Fixed issues with QLineEdit for mobile number; removed error button in homeview
2016-06-15 UART console now responding to commands properly; fake adc read commands implemented; code cleanup and beautify; should be ready for delivery
2016-06-15 Worked on master code to get it to communicate over UART with the sensors
2016-06-15 Fixed minor errors and added TODO for timeouts
    [main.c]
2016-06-15 Gesamtsystem der Validierung gemacht
2016-06-15 Changed text for software sensor to be more elaborative and adjusted diagram, also insertet flowchart for firmware routines
2016-06-15 GUI is now able to emmit an error if a fault is detected
    [GUI.py, Input_handler.py, reporter.py, serial_interface.py]
2016-06-15 Fixes in Text for Software Sensor
2016-06-15 Moar Diagrams
    new file: .gitignore
    new file: database.tex
    new file: inputHandler.tex
    new file: inputHandlerStandalone.tex
    modified: sensorProcess.tex
    modified: ../../main.ctr
    modified: ../../mainmatter/software-master.tex
    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
2016-06-16 New Screenshots GUI
    modified: ../../bibliography/references.bib
    new file: screen0.jpg
    new file: screen1.jpg
    new file: screen2.jpg
    new file: screen4.jpg
    modified: ../../main.tex
    modified: ../../mainmatter/firmware-sensor.tex
    modified: ../../mainmatter/hardware-sensor.tex
    modified: ../../mainmatter/software.tex
    modified: ../../mainmatter/validierung.tex
    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
2016-06-16 print for last review
2016-06-16 changed reset of the UART buffer to happen in the outermost scope
    [main.c]
